LoganFraser/VoronMods/README.md

# VoronMods
My modified files for the Voron Trident and V2.4 (if cross compatible)

Logan BC CA - Logan#2225 on VoronDesign Discord

If you like my work and want to buy me a beer (or coffee),  
you can use this [Paypal](https://www.paypal.me/designbylogan) link.
