LoganFraser/VoronMods/Trident 2.4r2 Combo Inlet Skirt/README.md

These skirt plates are for the fuse-filter-switch combo c14 inlets.  

The wide one is for the larger switch in Shaffner FN283-10-06 inlets
or other equivalent product from a reputable reseller. Amazon/Aliexpress not recommended.

The narrow one is for the smaller switch in the style of adamstech inlets.  I don't have an example part number.  
 
Both Inlet

Combo Inlets
