LoganFraser/VoronMods/Displays/README.md

These are hinged 30 degree to flat cases for the BTT PiTFT43 LCD and Waveshare 4.3in DSI LCD screens.  

https://www.biqu.equipment/products/bigtreetech-pi-tft43-v2-0-screen-board

https://www.waveshare.com/4.3inch-dsi-lcd.htm

The available files are in Fusion360, step, and stl (the hinge and rear brace are common to both displays) 

BOM: 
Primarily the same as the stock display for Trident:

  1 - M3-40mm SHCS bolt
  
  2 - M3-12mm SHCS bolt
  
  2 - M3-12mm FHCS bolt
  
  2 - M3 heatset 5x4mm
  
  1 - 115mm piece of 1.75mm filament as hinge

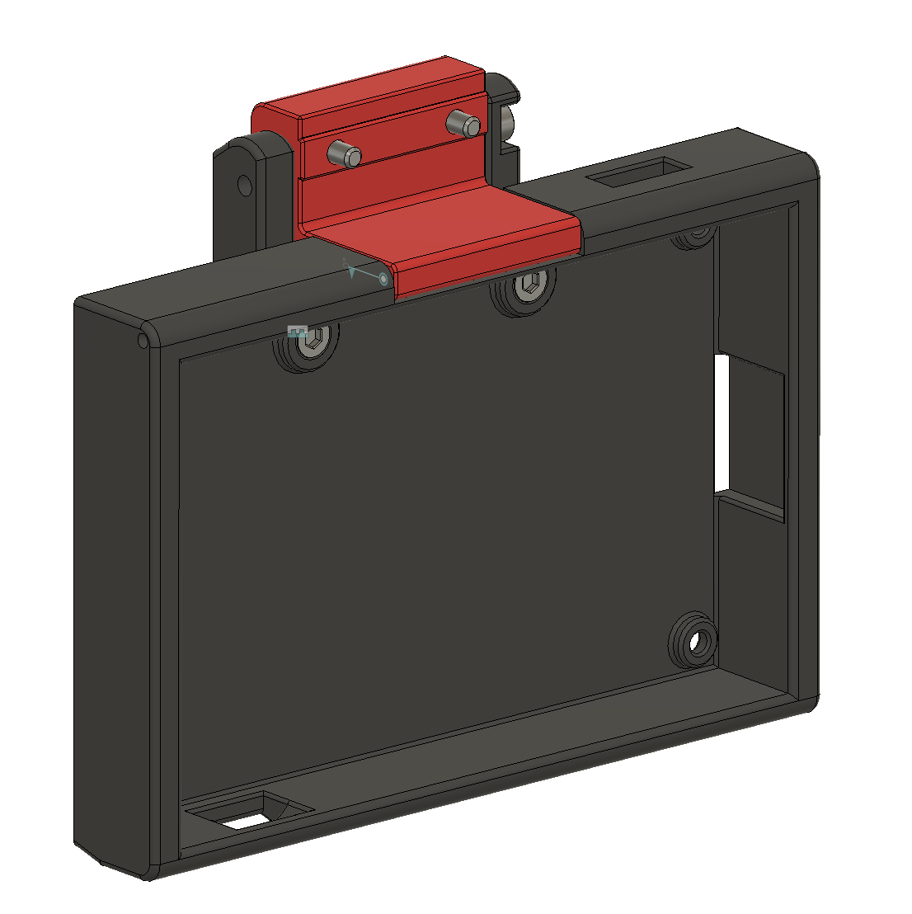
[picture p15: Displays/BTT PITFT43 LCD Mount.png]
Image of Display Mount
