LoganFraser/VoronMods/Displays/Waveshare 4.3in DSI LCD Mount.png

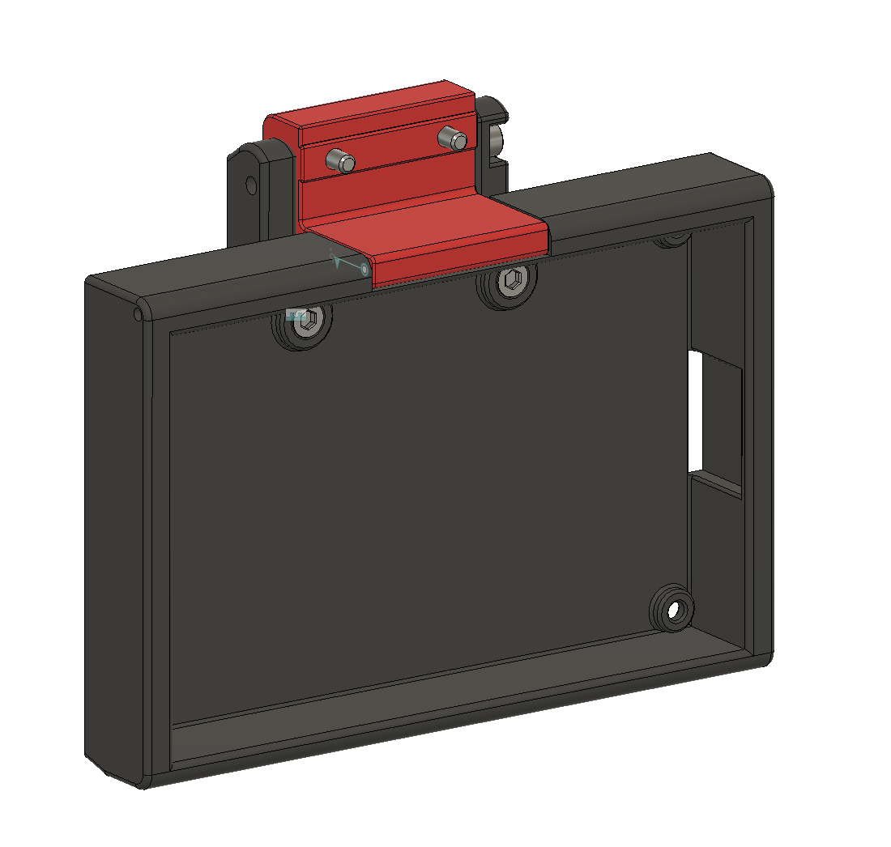
Displays/Waveshare 4.3in DSI LCD Mount.png
