LoganFraser/VoronMods/PCBs/Breakout_FFC_EXP1_PCB/Breakout_FFC_EXP1_PCB.png

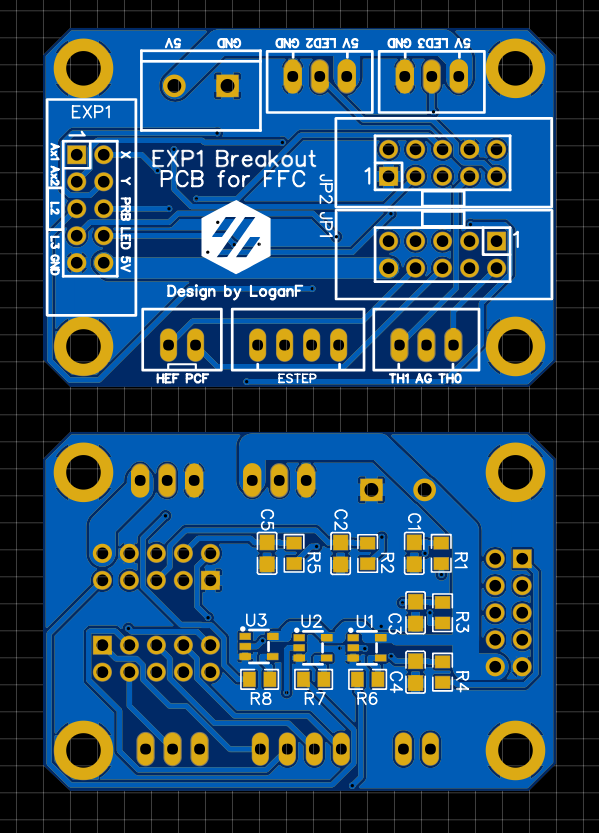
PCBs/Breakout_FFC_EXP1_PCB/Breakout_FFC_EXP1_PCB.png
