LoganFraser/VoronMods/PCBs/Breakout_Molex_EXP1_PCB/Breakout_Molex_EXP1_PCB.png

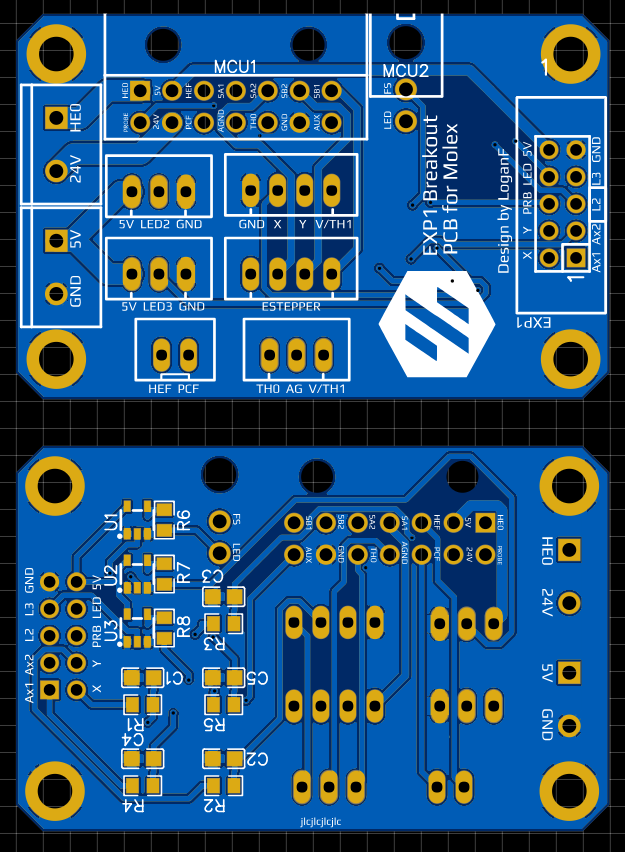
PCBs/Breakout_Molex_EXP1_PCB/Breakout_Molex_EXP1_PCB.png
