LoganFraser/VoronMods/PCBs/Stealthburner_2PC_FFC_PCB/SB_2PC_FFC_PCB.png

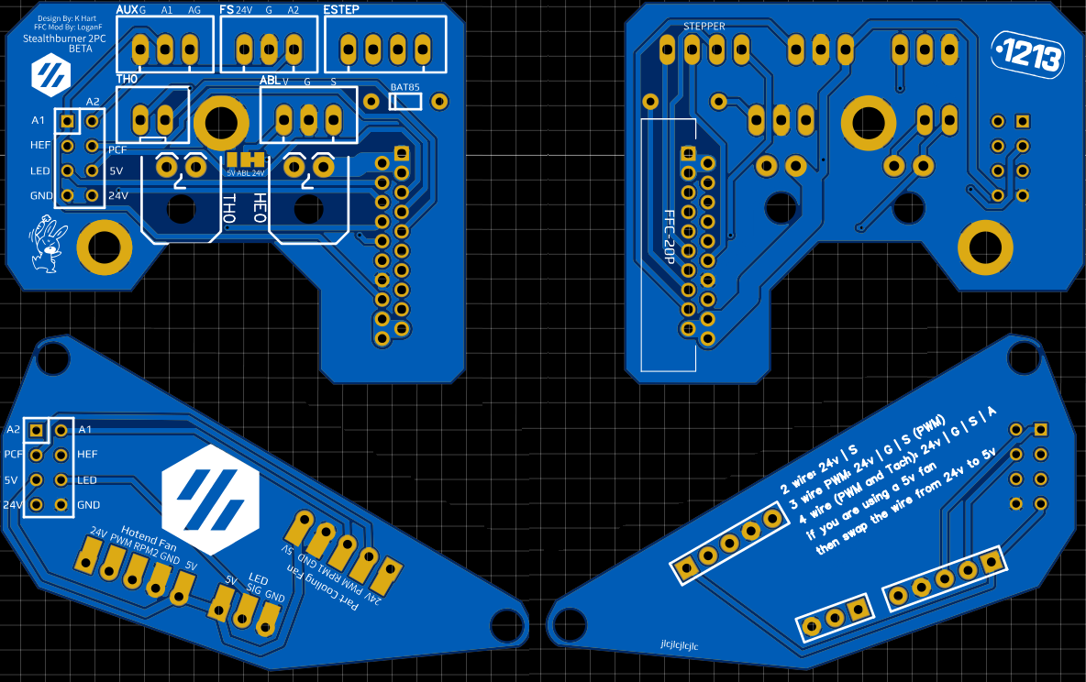
PCBs/Stealthburner_2PC_FFC_PCB/SB_2PC_FFC_PCB.png
