LoganFraser/VoronMods/PCBs/Stealthburner_2PC_Molex_PCB/SB_2PT_Molex_PCB.png

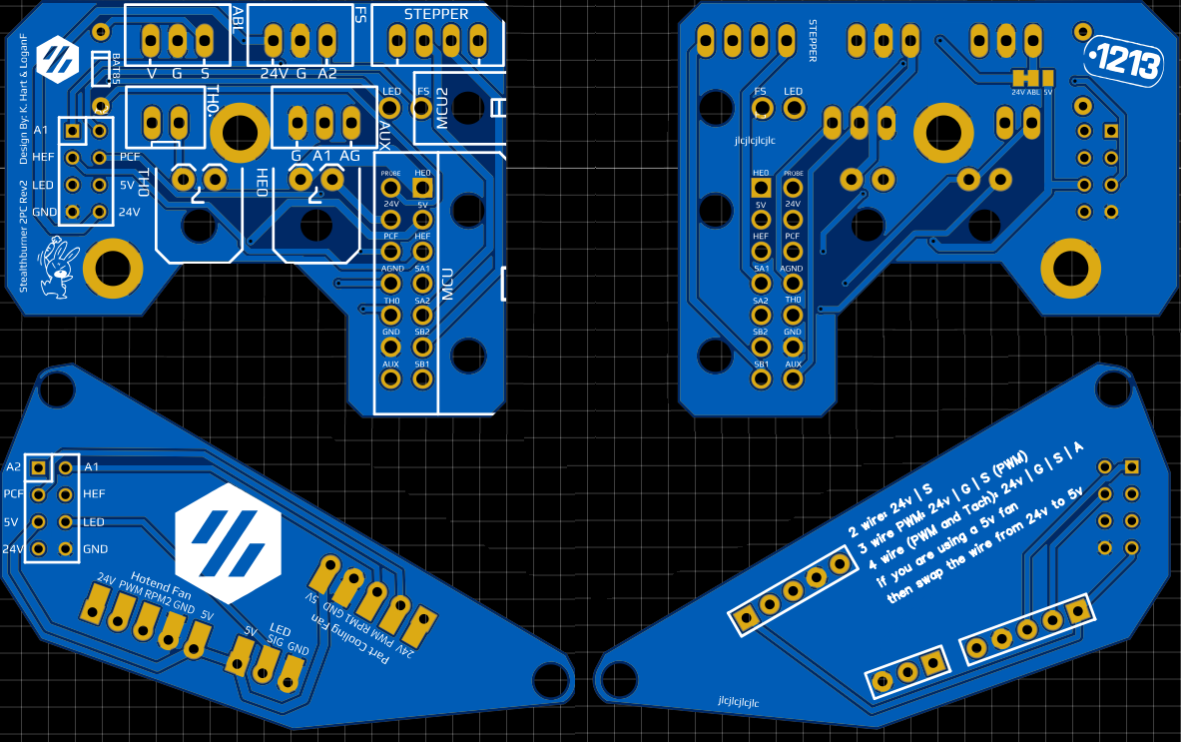
PCBs/Stealthburner_2PC_Molex_PCB/SB_2PT_Molex_PCB.png
