LoganFraser/VoronMods/PCBs/YZ_FFC_PCB/YZ_FFC_PCB.png

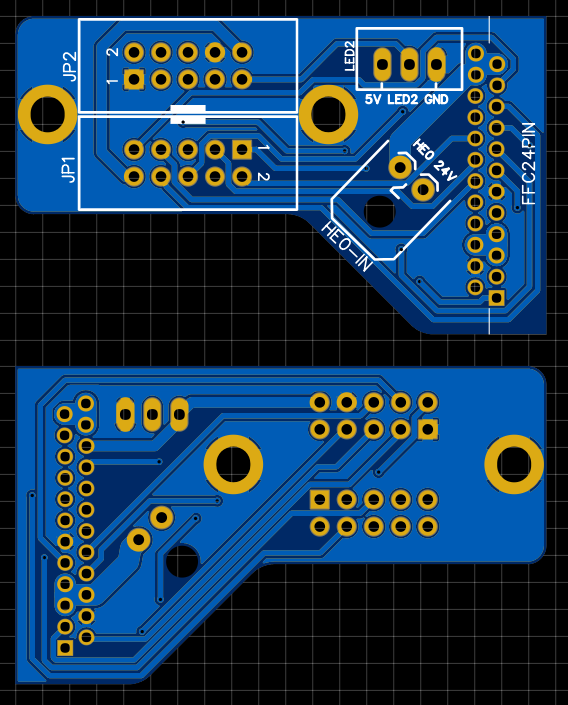
PCBs/YZ_FFC_PCB/YZ_FFC_PCB.png
