LoganFraser/VoronMods/ComboInlet/CAD/Trident_2.4_ComboInletSkirt v8.step

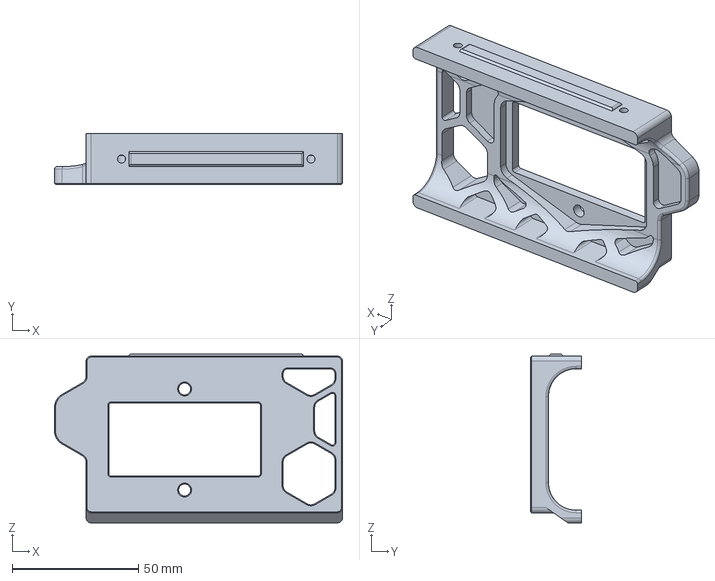
[picture p22: CAD file, 2022-06-28]
ComboInlet/CAD/Trident_2.4_ComboInletSkirt v8.step
114.0 x 20.0 x 66.8 mm
