LoganFraser/VoronMods/ComboInlet/STLs/2.4r2_ComboWideInlet.stl

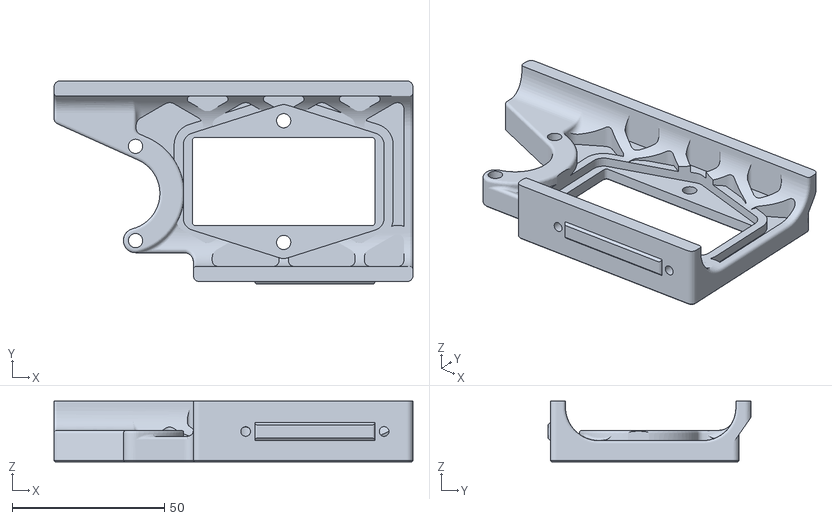
[picture p23: CAD file, 2022-06-28]
ComboInlet/STLs/2.4r2_ComboWideInlet.stl
118.0 x 66.8 x 20.0
