LoganFraser/VoronMods/DecontaminatorTrident/CAD/DecontaminatorTridentv4.step

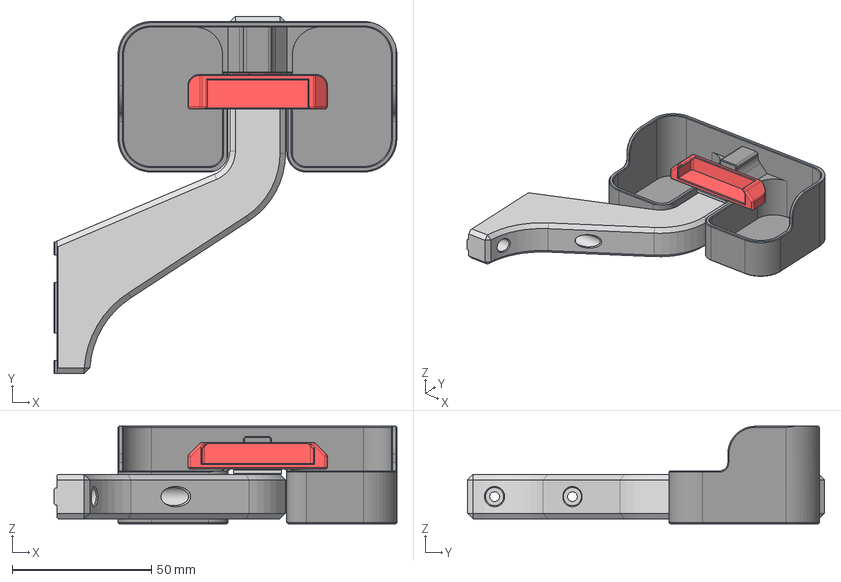
[picture p24: CAD file, 2022-05-15]
DecontaminatorTrident/CAD/DecontaminatorTridentv4.step
122.9 x 128.0 x 35.0 mm
DecontaminatorTridentBracket
BrushHolder
TridentBucket
2mmSpacer
