LoganFraser/VoronMods/DecontaminatorTrident/STLs/BrushHolder.stl

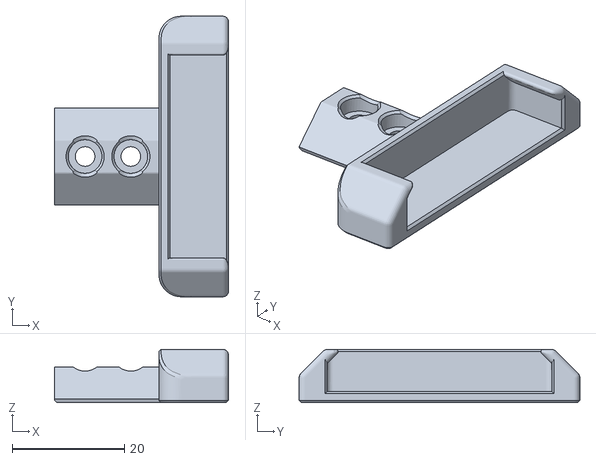
[picture p25: CAD file, 2022-05-15]
DecontaminatorTrident/STLs/BrushHolder.stl
31.0 x 50.0 x 9.50
