LoganFraser/VoronMods/Displays/Waveshare 4.3in DSI LCD Mount v2.step

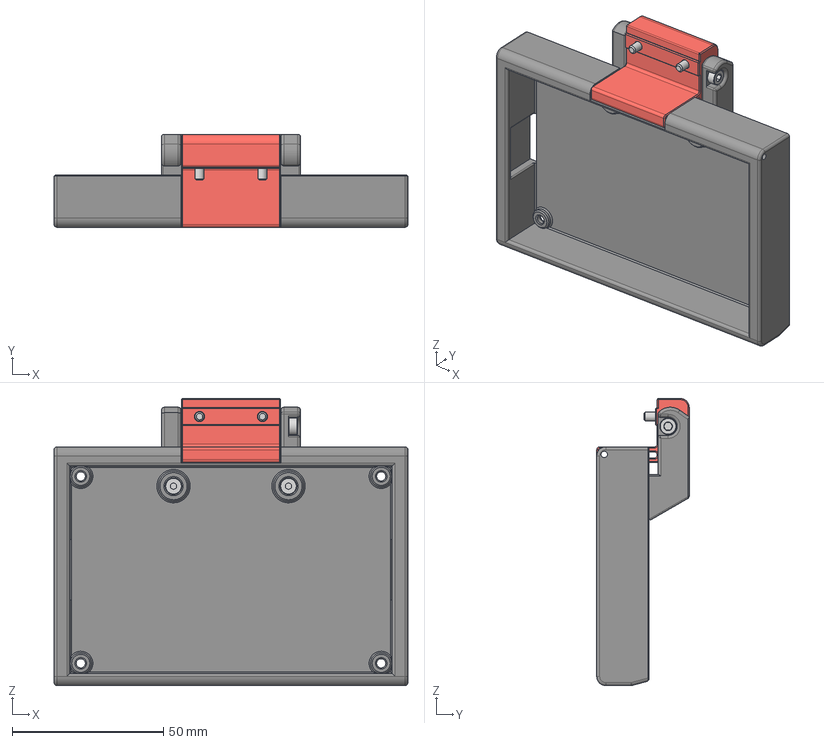
[picture p26: CAD file, 2022-02-15]
Displays/Waveshare 4.3in DSI LCD Mount v2.step
117.0 x 30.6 x 94.9 mm
LCD Case Front
M3x12 SHCS
M3x40 SHCS (5)
M3x12 SHCS (2)
M3x12 SHCS (12)
M3x12 SHCS (34)
M3x12 SHCS (33)
M3x12 SHCS (32)
M3 Threaded Insert x 2
M3x12 FHCS (1) x 2
