LoganFraser/VoronMods/HorseshoeSpoolHolder/CAD/HorseshoeSpoolHolder_v10.step

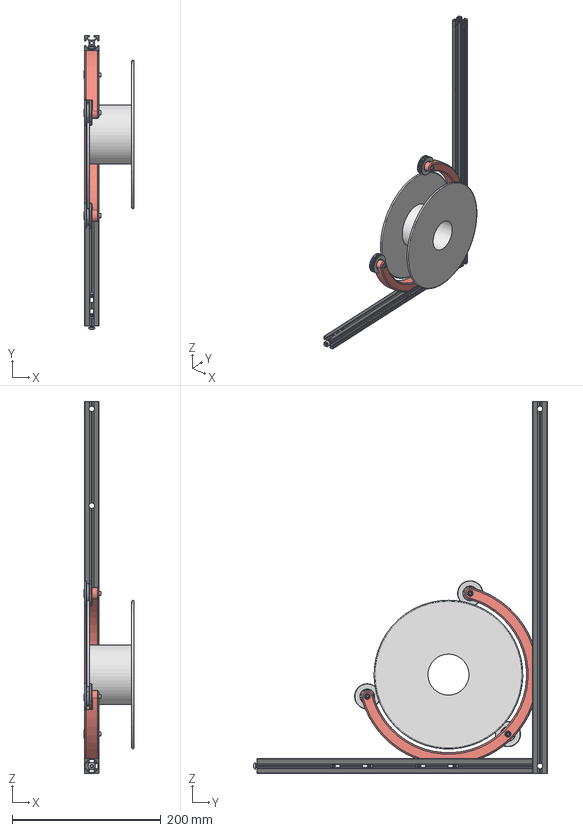
[picture p27: CAD file, 2022-05-01]
HorseshoeSpoolHolder/CAD/HorseshoeSpoolHolder_v10.step
67.2 x 394.8 x 500.0 mm
M5x16 BHCS (33)
M5x16 BHCS (32)
2020 Drop-in T-nut, M5 (28)
2020 Drop-in T-nut, M5 (31)
2020 Drop-in T-nut, M3 (38)
2020 Drop-in T-nut, M5 (32)
2020 Drop-in T-nut, M3 (39)
2020 Drop-in T-nut, M5 (52)
2020 Drop-in T-nut, M5 (51)
2020 Drop-in T-nut, M5 (50)
2020 Drop-in T-nut, M5 (49)
2020 Drop-in T-nut, M5 (48)
2020 Drop-in T-nut, M5 (47)
HFSB5-2020-500-LCP-RCP-AV360 (3)
M3x8 SHCS (3x) (1)
608BearingRing(6x)
Filament Spool
