LoganFraser/VoronMods/ParametricRemovable270Hinges/3mmPanel-1mmfoam-270swing-STLs/BackPlate 2x.stl

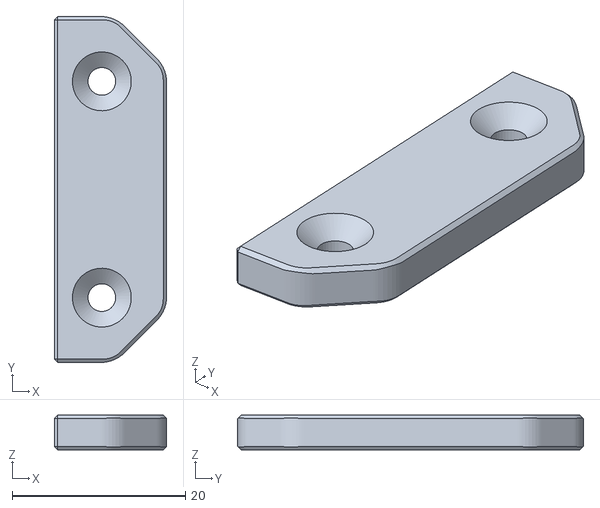
[picture p28: CAD file, 2022-04-01]
ParametricRemovable270Hinges/3mmPanel-1mmfoam-270swing-STLs/BackPlate 2x.stl
13.0 x 40.0 x 4.00
