LoganFraser/VoronMods/PCBs/FFC_Y_RISER_increased_height.stl

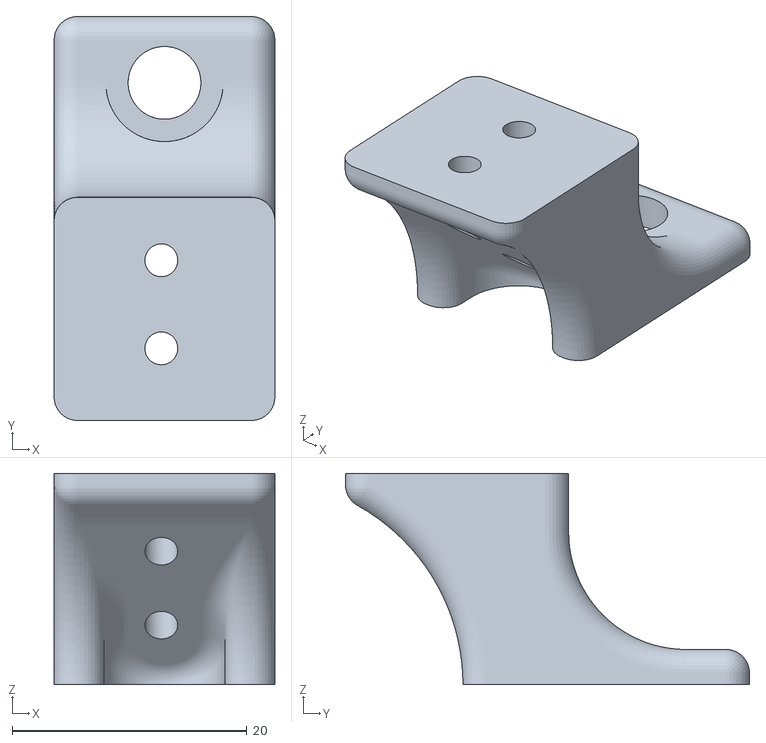
[picture p29: CAD file, 2022-01-11]
PCBs/FFC_Y_RISER_increased_height.stl
18.8 x 34.4 x 18.0
