LoganFraser/VoronMods/PiPlate/PiPlate_v16.step

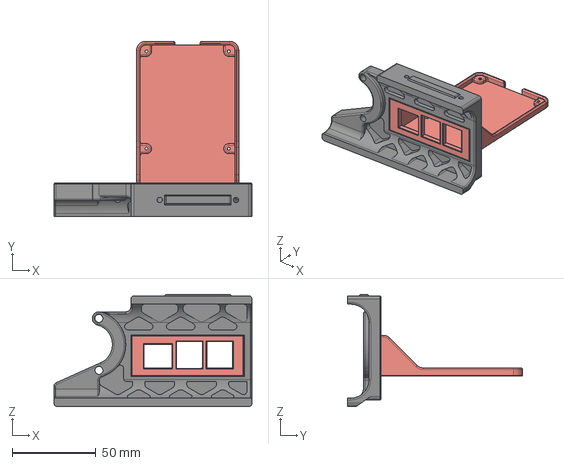
[picture p30: CAD file, 2022-04-15]
PiPlate/PiPlate_v16.step
118.0 x 104.5 x 66.8 mm
Pi3 Plate
2.4r2 Skirt for Pi Plate
