LoganFraser/VoronMods/PiPlate/STLs/2.4_250-300_Skirt_for_PiPlate.stl

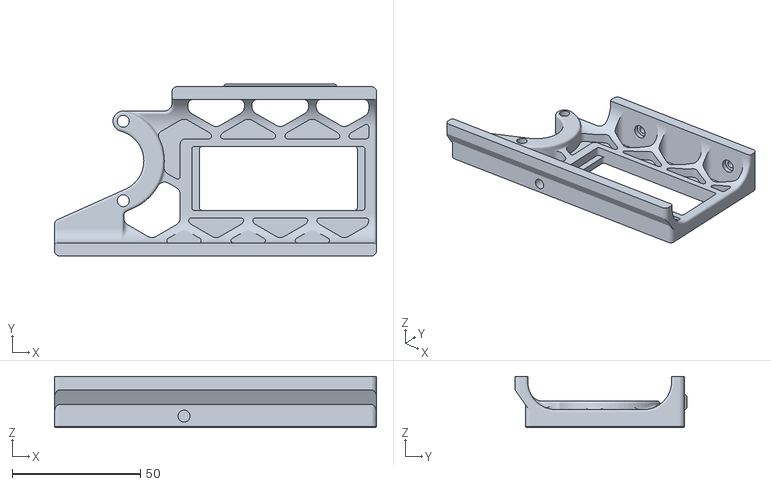
[picture p31: CAD file, 2022-04-15]
PiPlate/STLs/2.4_250-300_Skirt_for_PiPlate.stl
125.5 x 67.0 x 20.0
