LoganFraser/VoronMods/PTFEWrangler/PTFE Short Arm.stl

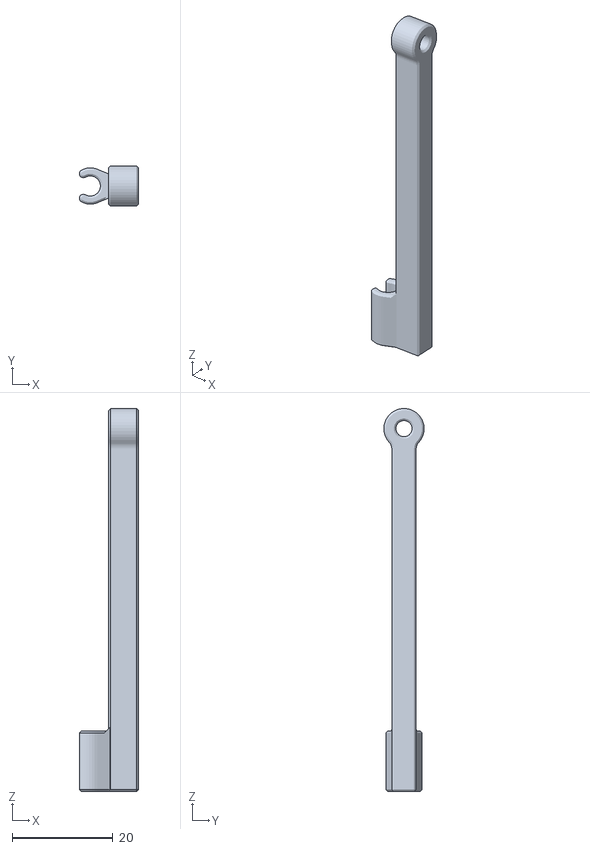
[picture p32: CAD file, 2023-12-09]
PTFEWrangler/PTFE Short Arm.stl
11.8 x 8.00 x 76.0
