LoganFraser/VoronMods/TridentInvertedElectronics/STLs/PanelLever.stl

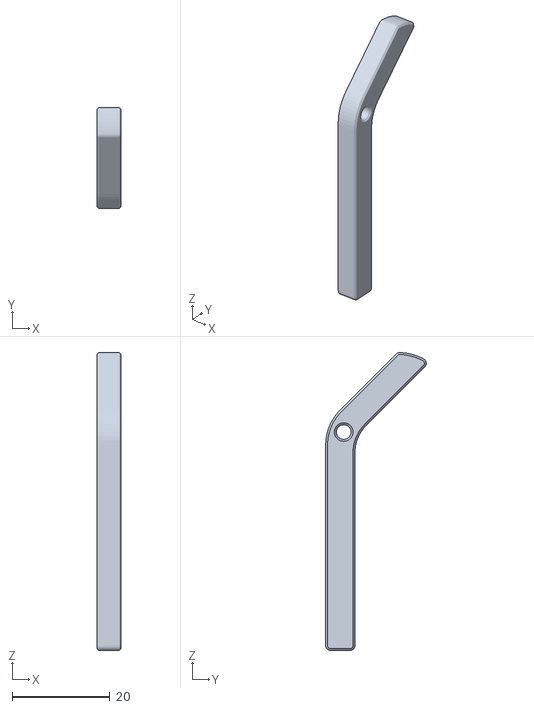
[picture p34: CAD file, 2022-05-15]
TridentInvertedElectronics/STLs/PanelLever.stl
5.00 x 20.6 x 61.0
