LoganFraser/VoronMods/TridentZStepperSpacer/STLs/Sepper_Spacer_Cover13mm.stl

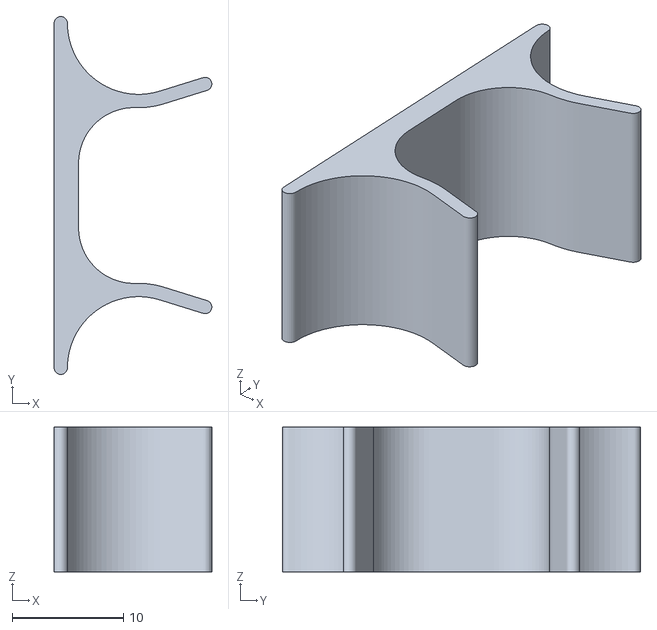
[picture p35: CAD file, 2022-03-13]
TridentZStepperSpacer/STLs/Sepper_Spacer_Cover13mm.stl
14.2 x 32.2 x 13.0
