LoganFraser/VoronMods/WagoMounts/CAD/Wago_221-41x_Extrusion_&_Thin_Din_Mount.step

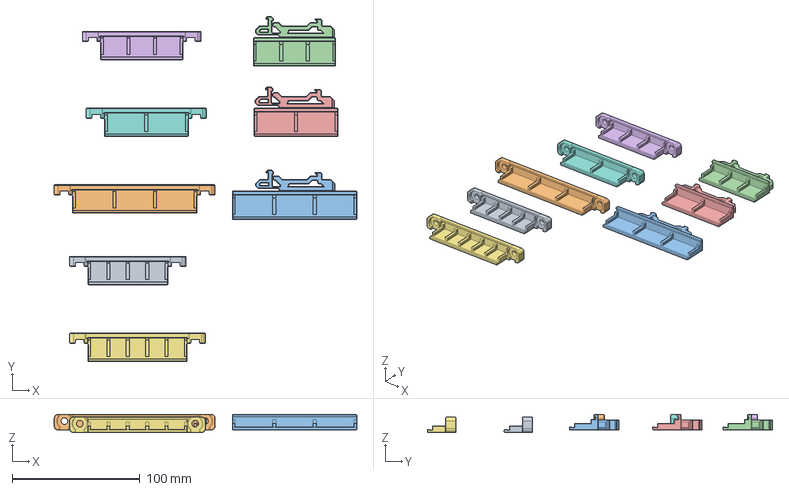
[picture p36: CAD file, 2022-02-19]
WagoMounts/CAD/Wago_221-41x_Extrusion_&_Thin_Din_Mount.step
236.7 x 269.9 x 14.2 mm
Wago 4x 221-412 Extrusion Mount
Wago 3x 221-415 Extrusion Mount x 2
M2x10 Self-tapping Screw (1)
M2x10 Self-tapping Screw (15)
Wago 3x 221-415 Thin Din Rail Mount x 2
Wago 3x 221-413 Thin Din Rail Mount
Wago 2x 221-415 Thin Din Rail Mount
Wago 3x 221-413 Extrusion Mount
Wago 5x 221-412 Extrusion Mount
Wago 2x 221-415 Extrusion Mount
