LoganFraser/VoronMods/WagoMounts/STLs/Din_Mount_Bracket.stl

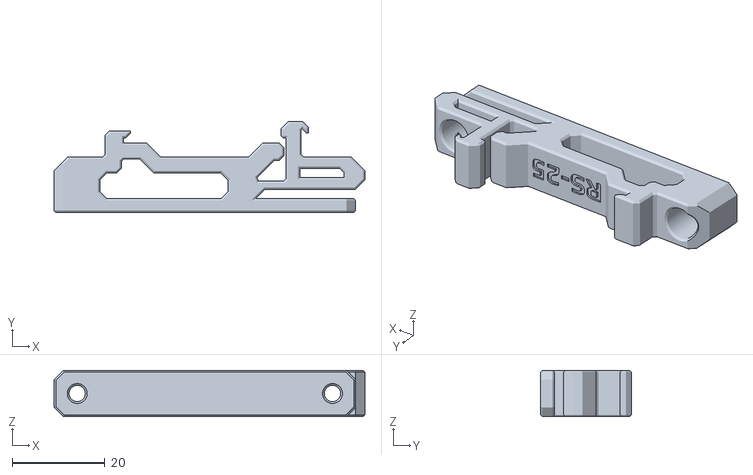
[picture p37: CAD file, 2022-04-26]
WagoMounts/STLs/Din_Mount_Bracket.stl
67.0 x 19.6 x 10.0
