LoganFraser/VoronMods/DecontaminatorTrident/STLs/4mmSpacer.stl

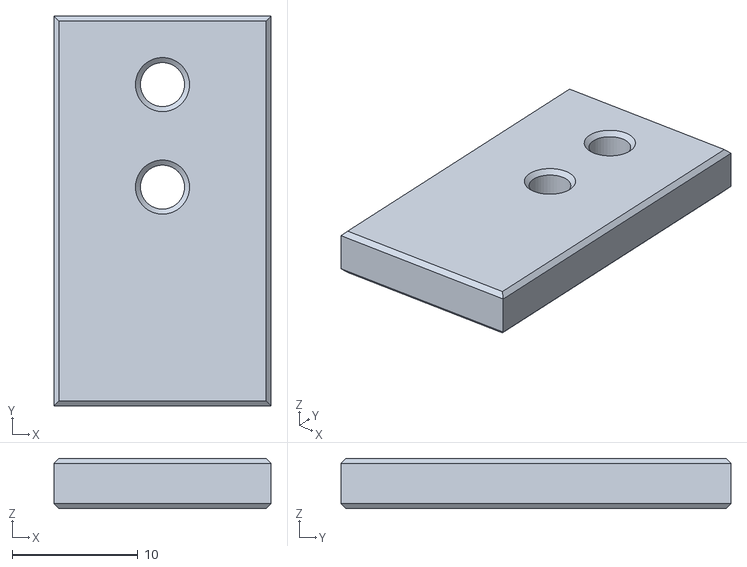
[picture p38: CAD file, 2022-05-15]
DecontaminatorTrident/STLs/4mmSpacer.stl
17.3 x 31.0 x 4.00
