LoganFraser/VoronMods/HorseshoeSpoolHolder/STLs/ExternalSpoolHolder.stl

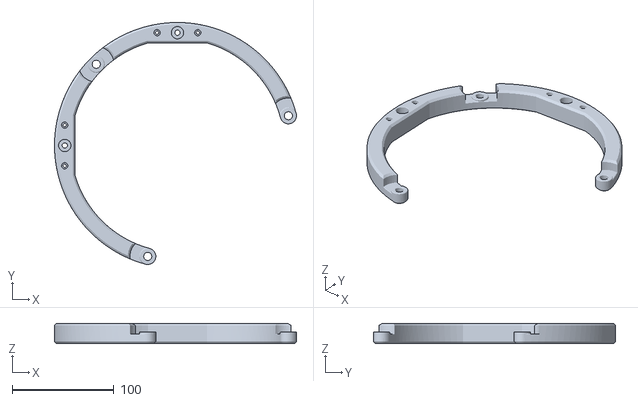
[picture p39: CAD file, 2022-05-01]
HorseshoeSpoolHolder/STLs/ExternalSpoolHolder.stl
238.1 x 238.1 x 20.0
