LoganFraser/VoronMods/ParametricRemovable270Hinges/3mmPanel-1mmfoam-270swing-STLs/HingeFrame.stl

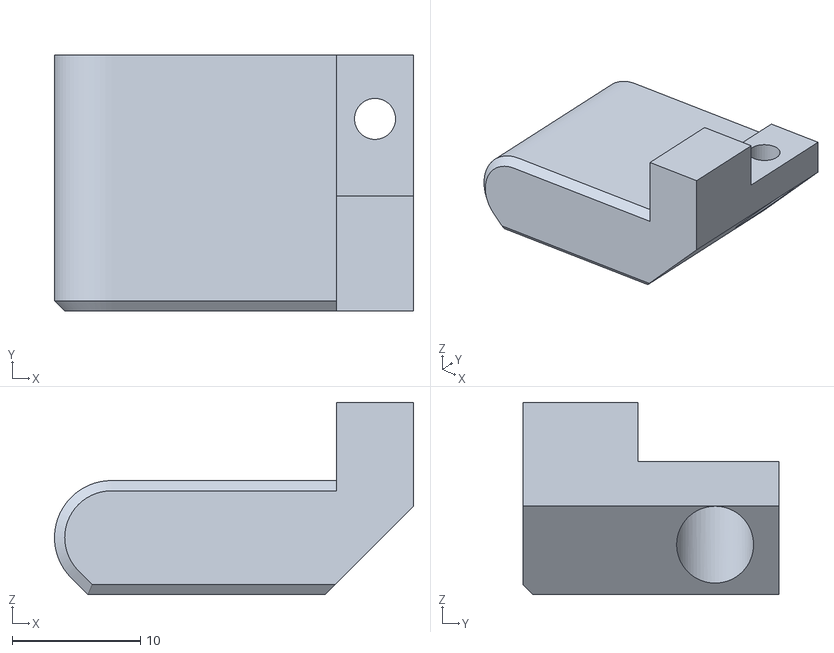
[picture p40: CAD file, 2022-04-01]
ParametricRemovable270Hinges/3mmPanel-1mmfoam-270swing-STLs/HingeFrame.stl
28.0 x 20.0 x 15.0
