LoganFraser/VoronMods/PCBs/ffc_anchor.stl

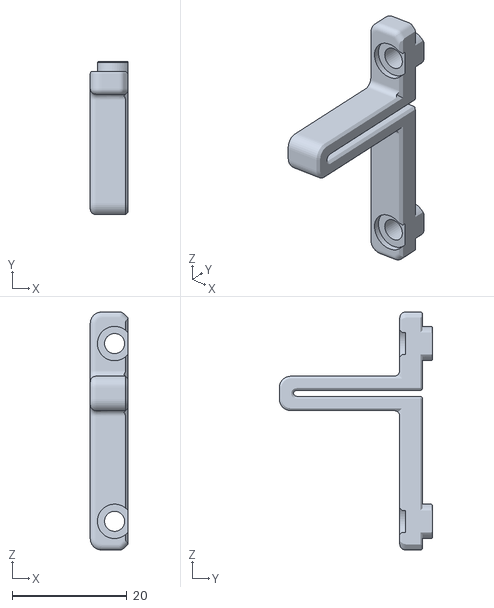
[picture p41: CAD file, 2022-01-11]
PCBs/ffc_anchor.stl
6.55 x 26.7 x 41.5
