LoganFraser/VoronMods/PiPlate/STLs/Trident_Skirt_for_PiPlate.stl

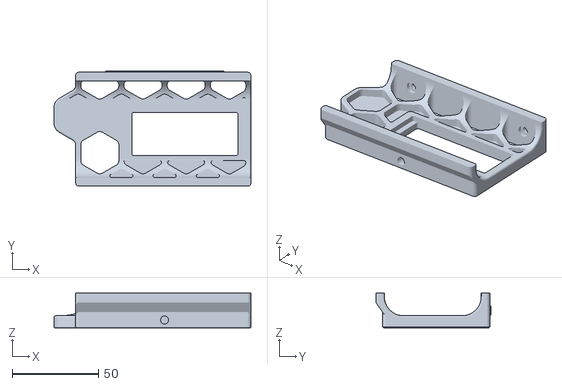
[picture p42: CAD file, 2022-04-15]
PiPlate/STLs/Trident_Skirt_for_PiPlate.stl
114.0 x 66.8 x 20.0
