LoganFraser/VoronMods/PTFEWrangler/Arm Mount.stl

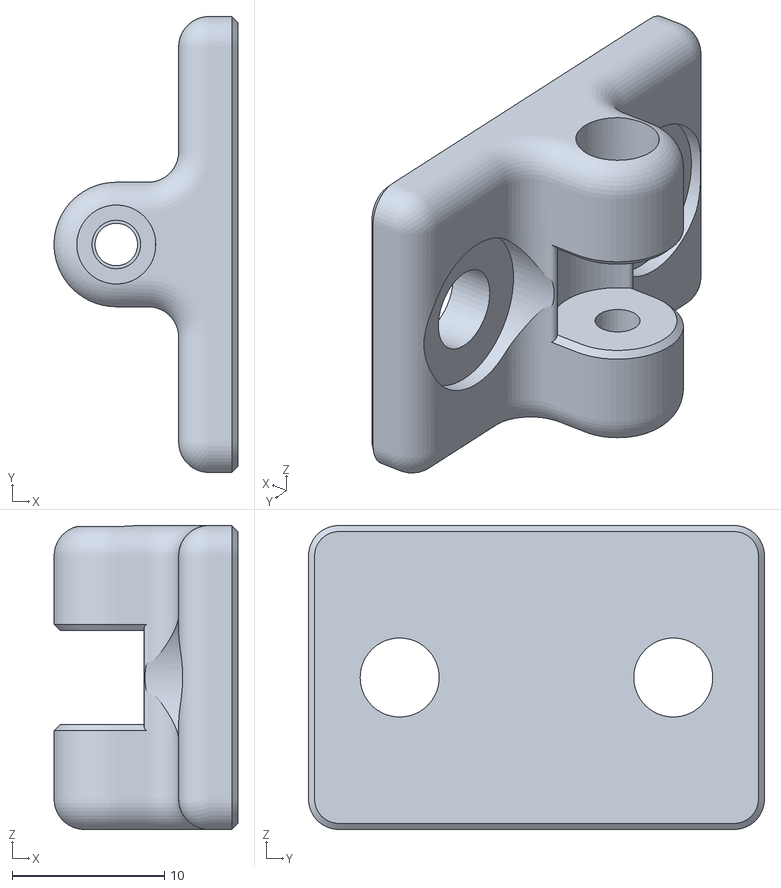
[picture p43: CAD file, 2023-12-09]
PTFEWrangler/Arm Mount.stl
12.1 x 30.0 x 20.0
