LoganFraser/VoronMods/Trident Idler Tensioner/STLs/[a]_tensioner_left.stl

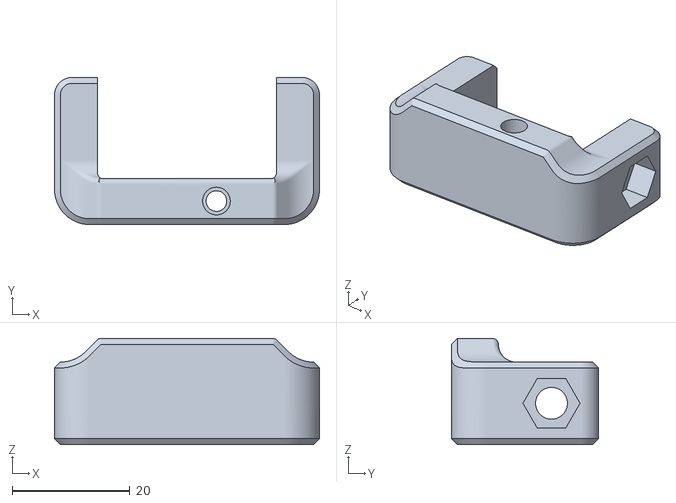
[picture p44: CAD file, 2022-02-27]
Trident Idler Tensioner/STLs/[a]_tensioner_left.stl
45.0 x 25.0 x 18.0
