LoganFraser/VoronMods/TridentInvertedElectronics/r1 STLs/Bottom_panel_clip x6.stl

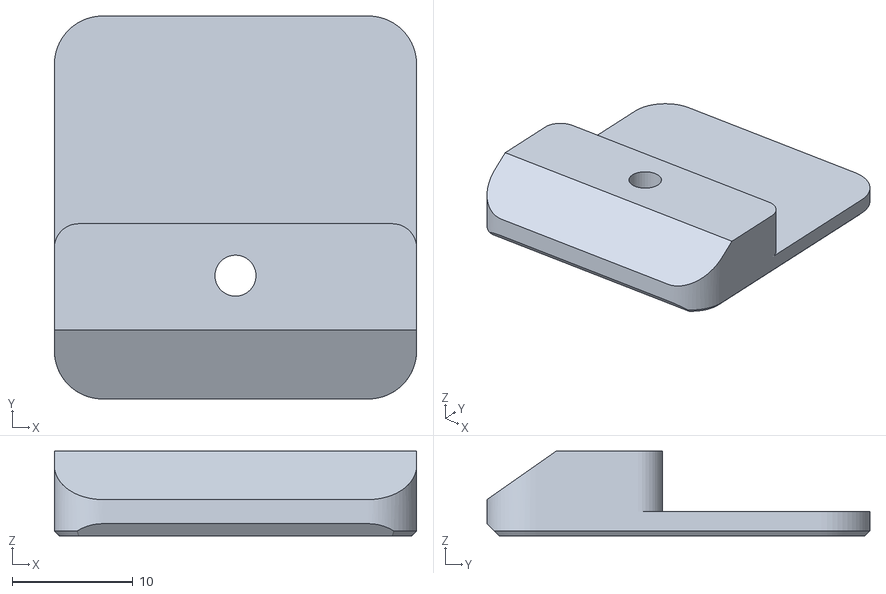
[picture p45: CAD file, 2022-02-23]
TridentInvertedElectronics/r1 STLs/Bottom_panel_clip x6.stl
30.0 x 31.7 x 7.00
