LoganFraser/VoronMods/TridentInvertedElectronics/STLs/PanelLeverFrameMount.stl

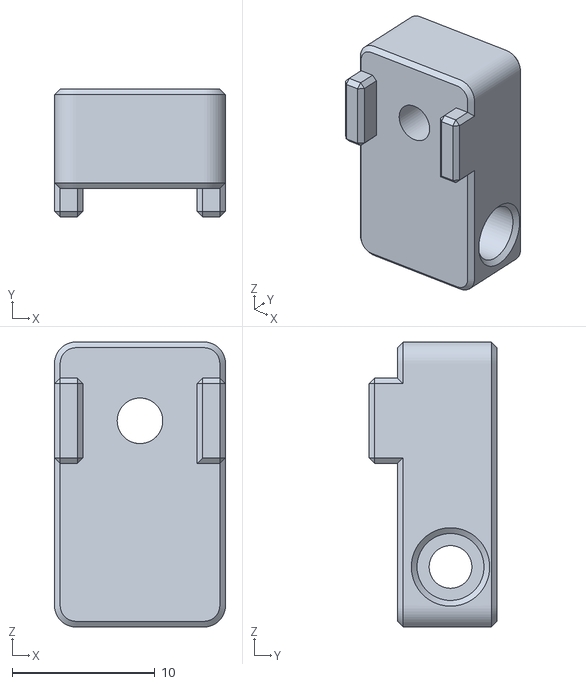
[picture p46: CAD file, 2022-05-15]
TridentInvertedElectronics/STLs/PanelLeverFrameMount.stl
12.0 x 9.00 x 20.0
