LoganFraser/VoronMods/TridentZStepperSpacer/STLs/Stepper_Spacer13mm.stl

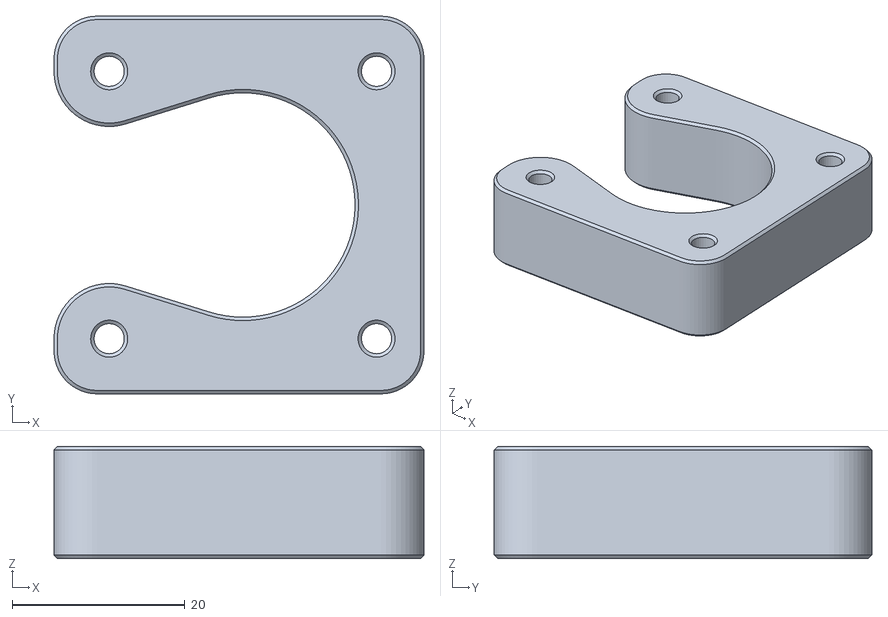
[picture p47: CAD file, 2022-03-13]
TridentZStepperSpacer/STLs/Stepper_Spacer13mm.stl
42.9 x 43.8 x 13.0
