LoganFraser/VoronMods/WagoMounts/CAD/Wago_3x_221-41x_Angled_Din_Rail_Mount.step

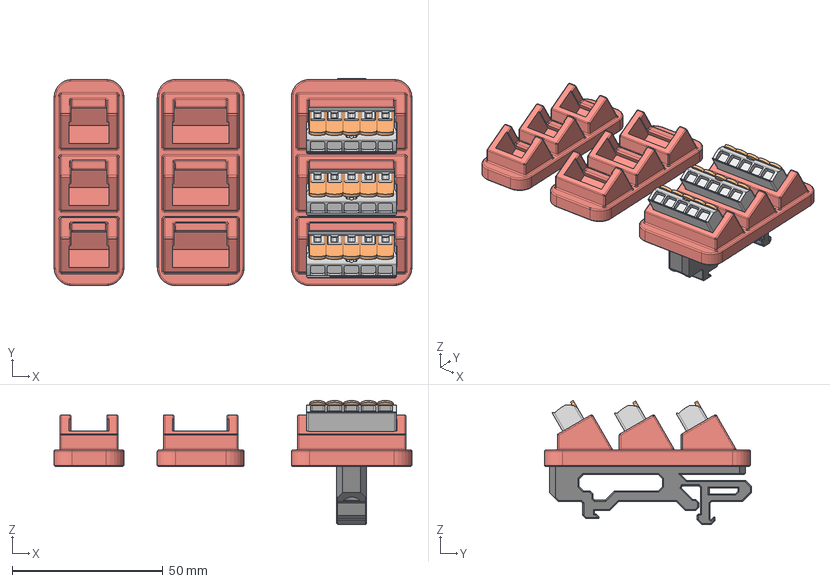
[picture p48: CAD file, 2021-12-31]
WagoMounts/CAD/Wago_3x_221-41x_Angled_Din_Rail_Mount.step
118.6 x 68.6 x 41.1 mm
Z.221-415 v1 x 2
Z.221-415 v1 (1)
Z.221-415 v1 (2)
RS-25 PSU Bracket
Wago 221-415 DIN Mount
Wago 221-413 DIN Mount
Wago 221-412 DIN Mount
