LoganFraser/VoronMods/WagoMounts/STLs/Wago_5x_221-412_Extrusion_Mount.stl

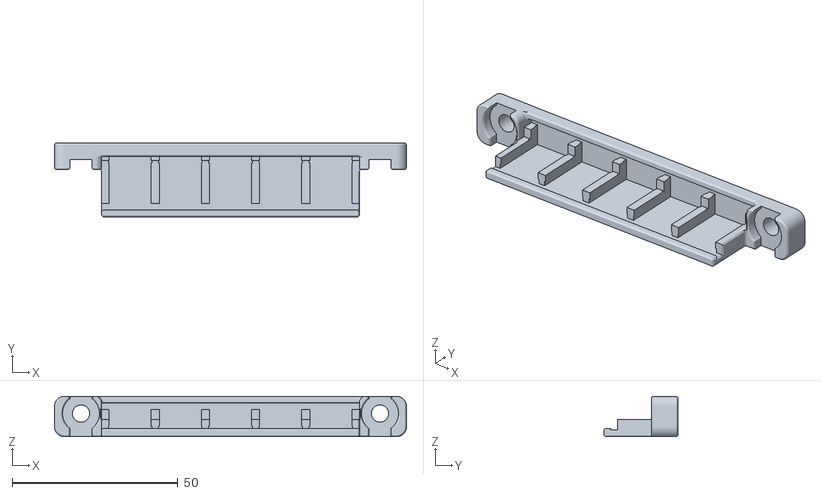
[picture p49: CAD file, 2022-02-19]
WagoMounts/STLs/Wago_5x_221-412_Extrusion_Mount.stl
106.2 x 22.2 x 12.2
