LoganFraser/VoronMods/ComboInlet/STLs/2.4r2_ComboNarrowInlet.stl

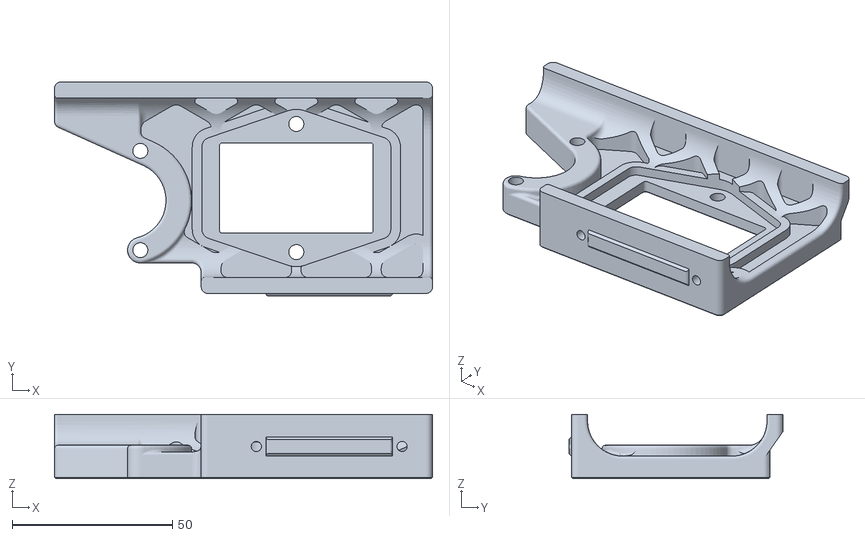
[picture p50: CAD file, 2022-06-28]
ComboInlet/STLs/2.4r2_ComboNarrowInlet.stl
118.0 x 66.8 x 20.0
