LoganFraser/VoronMods/DecontaminatorTrident/STLs/TridentBracket.stl

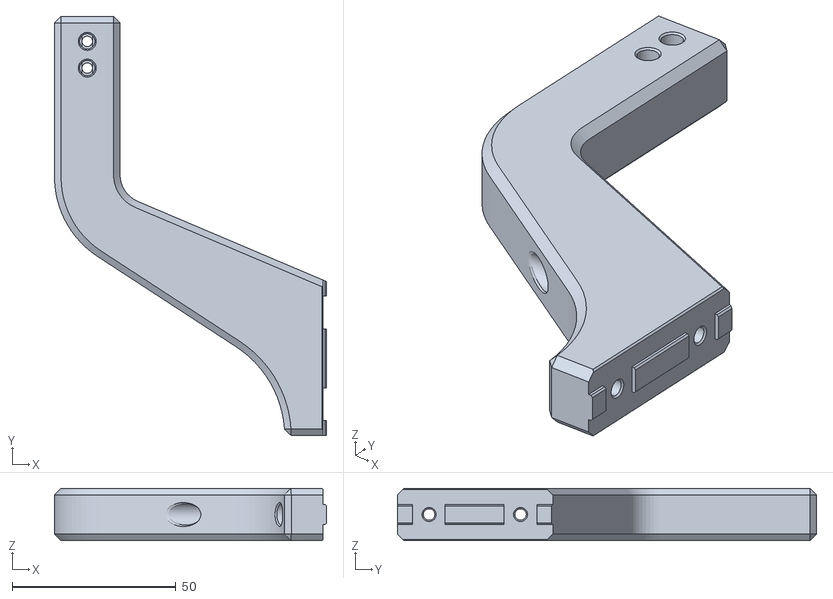
[picture p51: CAD file, 2022-05-15]
DecontaminatorTrident/STLs/TridentBracket.stl
83.0 x 128.0 x 16.0
