LoganFraser/VoronMods/Displays/LCD Case Hinge.stl

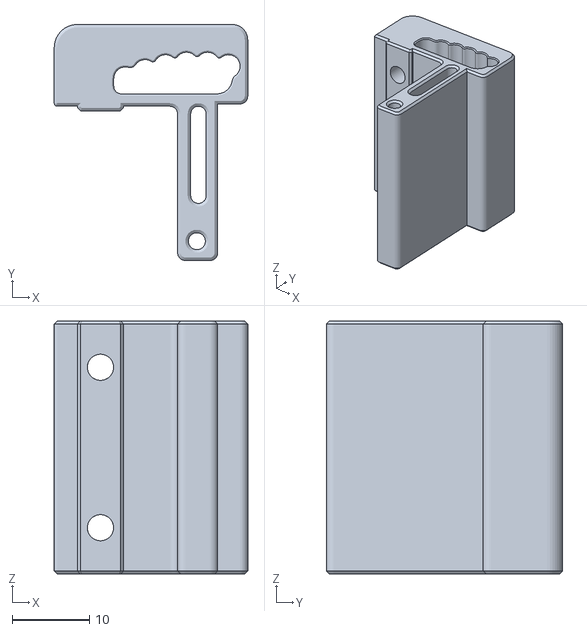
[picture p52: CAD file, 2022-02-13]
Displays/LCD Case Hinge.stl
25.1 x 30.6 x 32.8
