LoganFraser/VoronMods/ParametricRemovable270Hinges/3mmPanel-1mmfoam-270swing-STLs/Drill Guide.stl

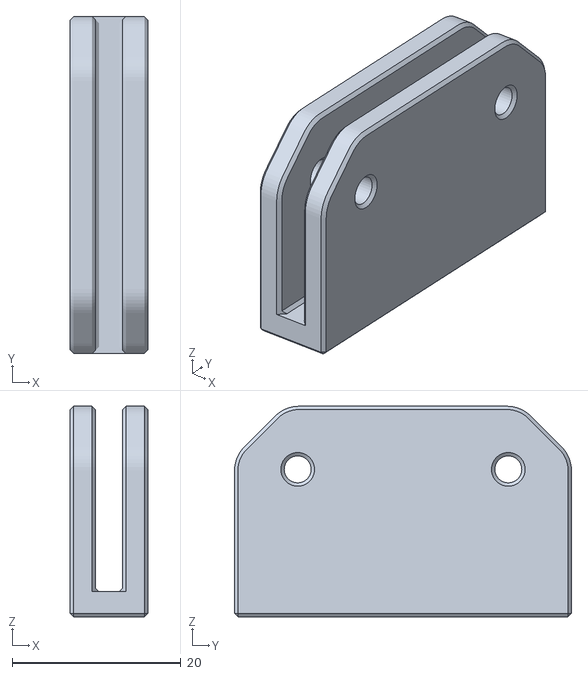
[picture p53: CAD file, 2022-04-01]
ParametricRemovable270Hinges/3mmPanel-1mmfoam-270swing-STLs/Drill Guide.stl
9.20 x 40.0 x 25.0
