LoganFraser/VoronMods/PTFEWrangler/PTFE Long Arm.stl

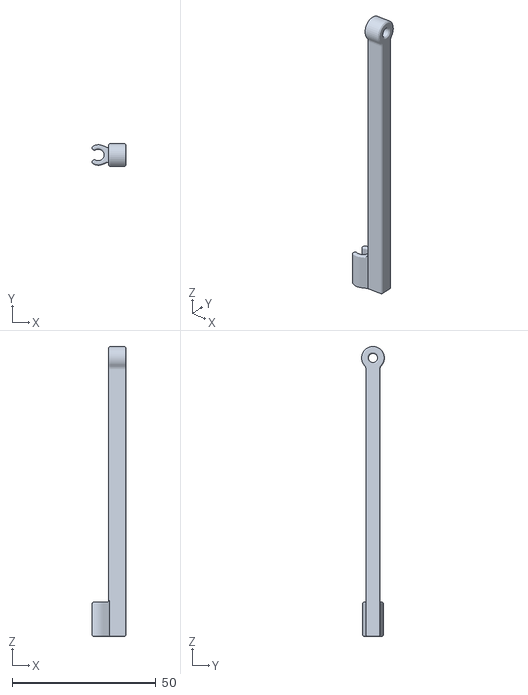
[picture p54: CAD file, 2023-12-09]
PTFEWrangler/PTFE Long Arm.stl
11.8 x 8.00 x 101.0
