LoganFraser/VoronMods/TridentInvertedElectronics/r1 STLs/Fan Cover x2.stl

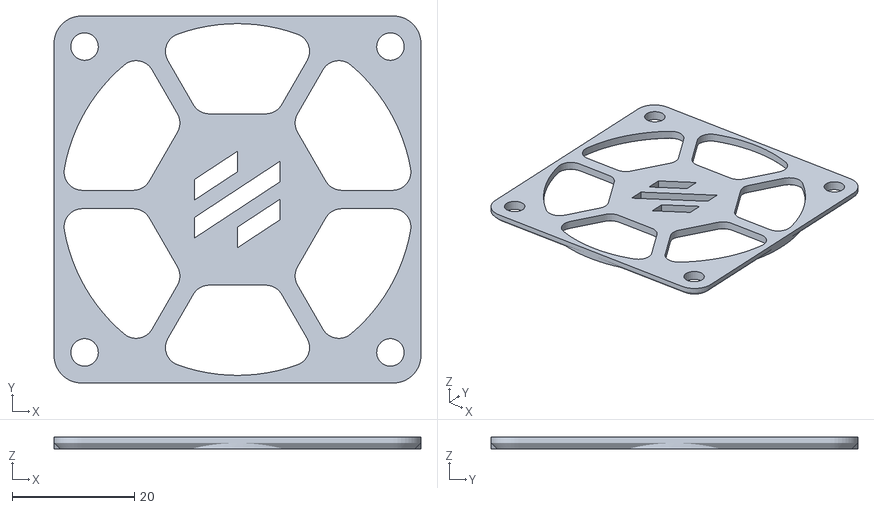
[picture p55: CAD file, 2022-02-23]
TridentInvertedElectronics/r1 STLs/Fan Cover x2.stl
60.0 x 60.0 x 2.00
