LoganFraser/VoronMods/TridentInvertedElectronics/STLs/Inverted_DIN_Mount_x2.stl

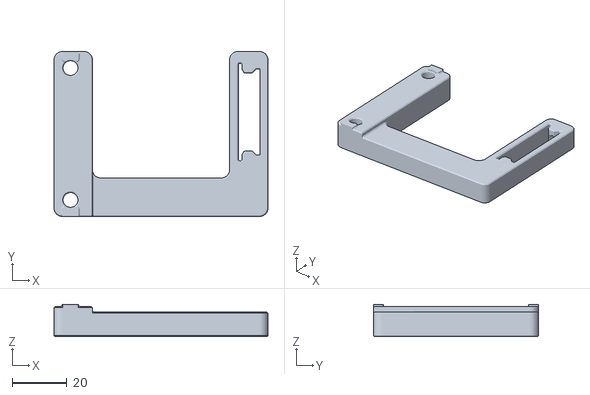
[picture p56: CAD file, 2022-04-16]
TridentInvertedElectronics/STLs/Inverted_DIN_Mount_x2.stl
77.9 x 60.0 x 11.8
