LoganFraser/VoronMods/TridentZStepperSpacer/STLs/Stepper_Spacer20mm.stl

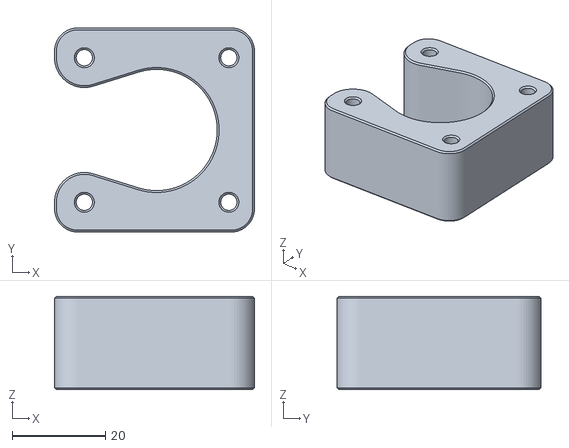
[picture p57: CAD file, 2022-03-13]
TridentZStepperSpacer/STLs/Stepper_Spacer20mm.stl
42.9 x 43.8 x 20.0
