LoganFraser/VoronMods/WagoMounts/STLs/Wago_2x_221-415_Extrusion_Mount.stl

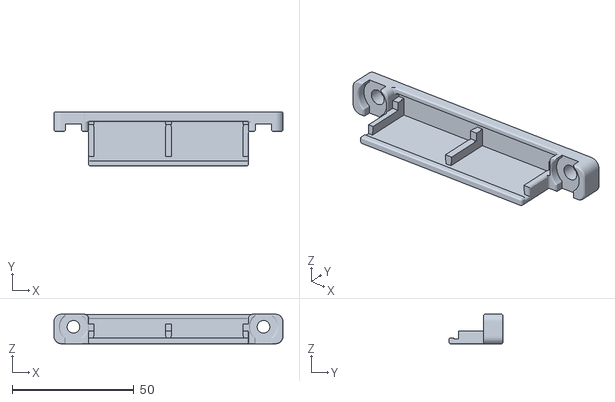
[picture p58: CAD file, 2022-02-19]
WagoMounts/STLs/Wago_2x_221-415_Extrusion_Mount.stl
94.1 x 22.2 x 12.2
