LoganFraser/VoronMods/ComboInlet/STLs/2.4_ComboWideInlet.stl

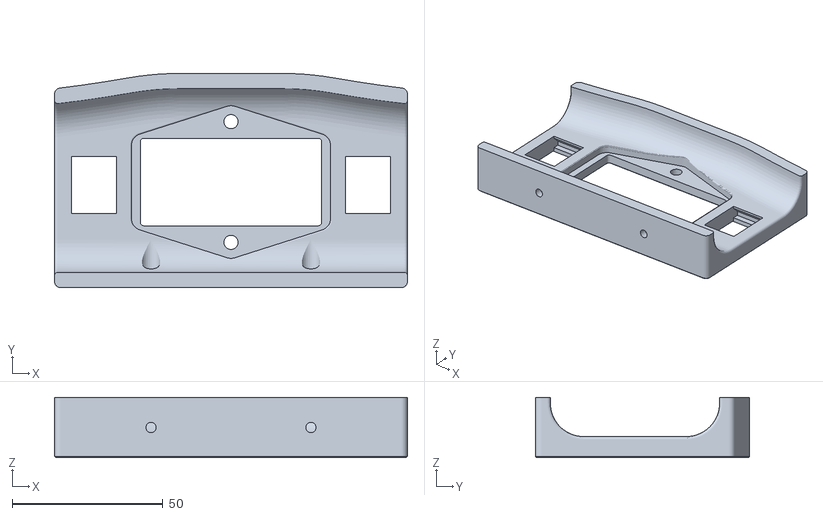
[picture p59: CAD file, 2022-06-10]
ComboInlet/STLs/2.4_ComboWideInlet.stl
117.0 x 71.0 x 20.0
