LoganFraser/VoronMods/DecontaminatorTrident/STLs/2mmSpacer.stl

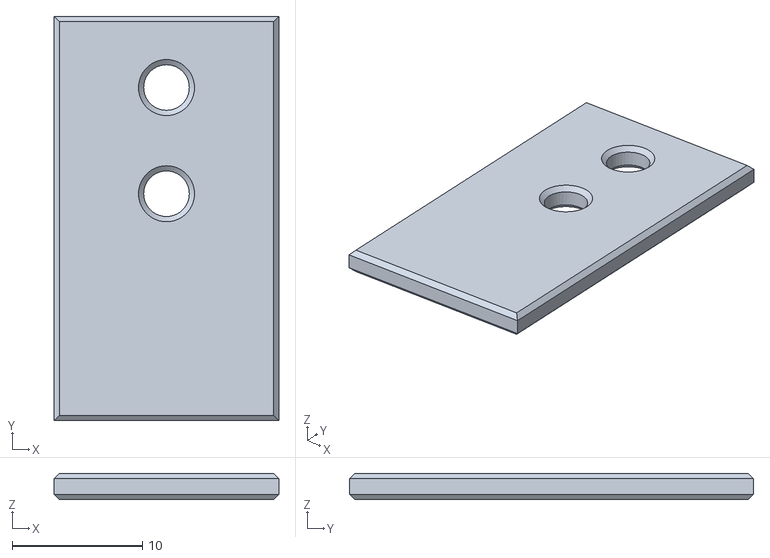
[picture p60: CAD file, 2022-05-15]
DecontaminatorTrident/STLs/2mmSpacer.stl
17.3 x 31.0 x 2.00
