LoganFraser/VoronMods/Displays/BTT PITFT43 LCD Case Front.stl

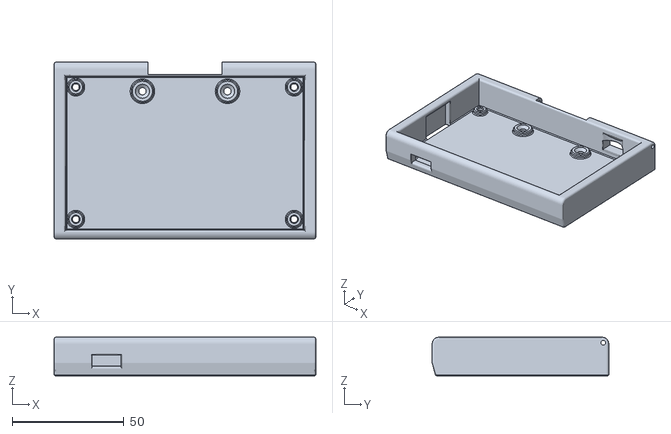
[picture p61: CAD file, 2022-02-13]
Displays/BTT PITFT43 LCD Case Front.stl
117.0 x 78.9 x 17.3
