LoganFraser/VoronMods/HorseshoeSpoolHolder/STLs/Trident_InternalSpoolHolder.stl

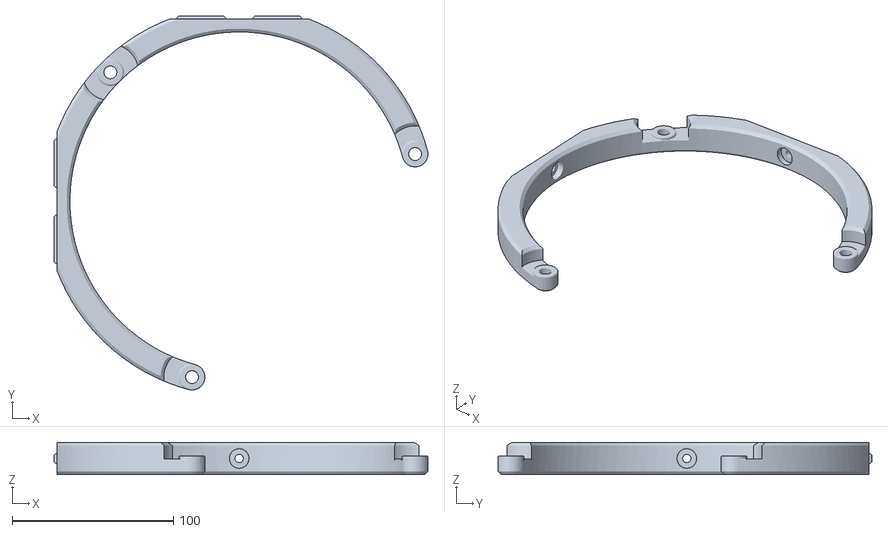
[picture p62: CAD file, 2022-04-30]
HorseshoeSpoolHolder/STLs/Trident_InternalSpoolHolder.stl
232.1 x 232.1 x 20.0
