LoganFraser/VoronMods/ParametricRemovable270Hinges/3mmPanel-1mmfoam-270swing-STLs/HingeDoor(Mirror).stl

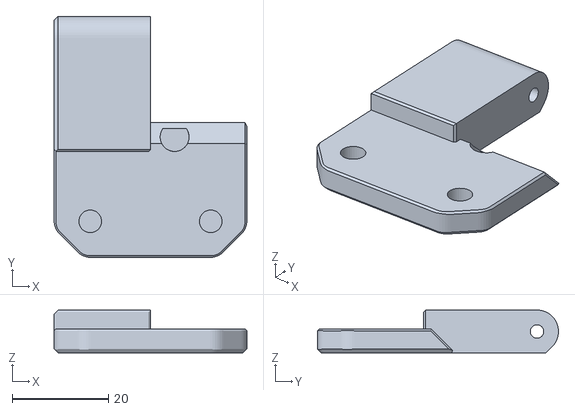
[picture p63: CAD file, 2022-04-01]
ParametricRemovable270Hinges/3mmPanel-1mmfoam-270swing-STLs/HingeDoor(Mirror).stl
40.0 x 50.0 x 8.90
