LoganFraser/VoronMods/PiPlate/STLs/2.4_350_Skirt_for_PiPlate.stl

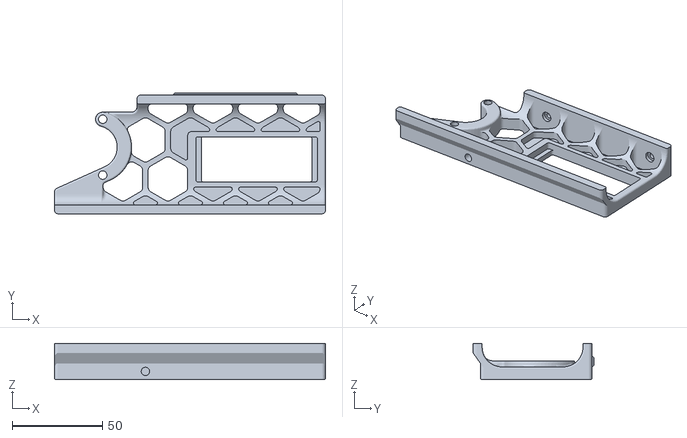
[picture p64: CAD file, 2022-04-15]
PiPlate/STLs/2.4_350_Skirt_for_PiPlate.stl
150.5 x 67.0 x 20.0
