LoganFraser/VoronMods/PTFEWrangler/90degreePTFEsupport.stl

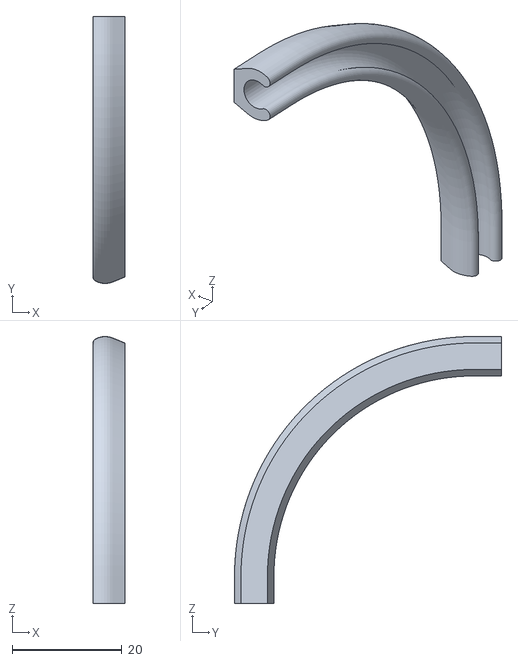
[picture p65: CAD file, 2023-12-09]
PTFEWrangler/90degreePTFEsupport.stl
5.80 x 48.6 x 48.6
