LoganFraser/VoronMods/Trident Idler Tensioner/STLs/front_idler_b_x2.stl

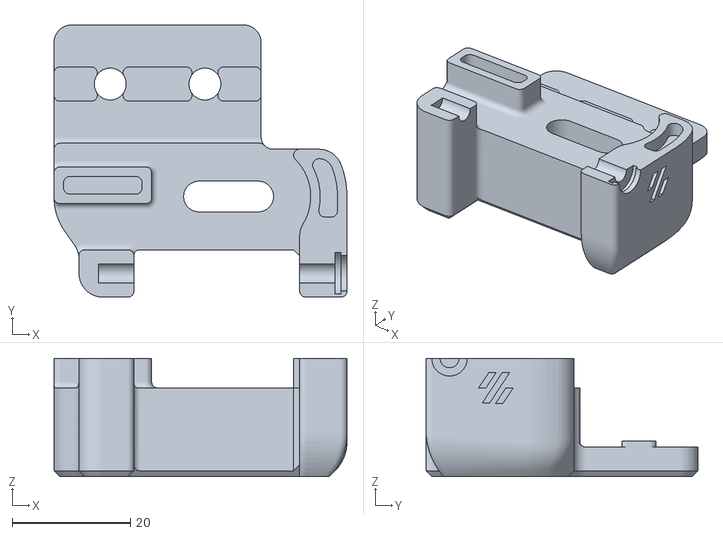
[picture p66: CAD file, 2022-02-27]
Trident Idler Tensioner/STLs/front_idler_b_x2.stl
49.5 x 46.0 x 20.0
