LoganFraser/VoronMods/TridentInvertedElectronics/r1 STLs/fan_blank x2.stl

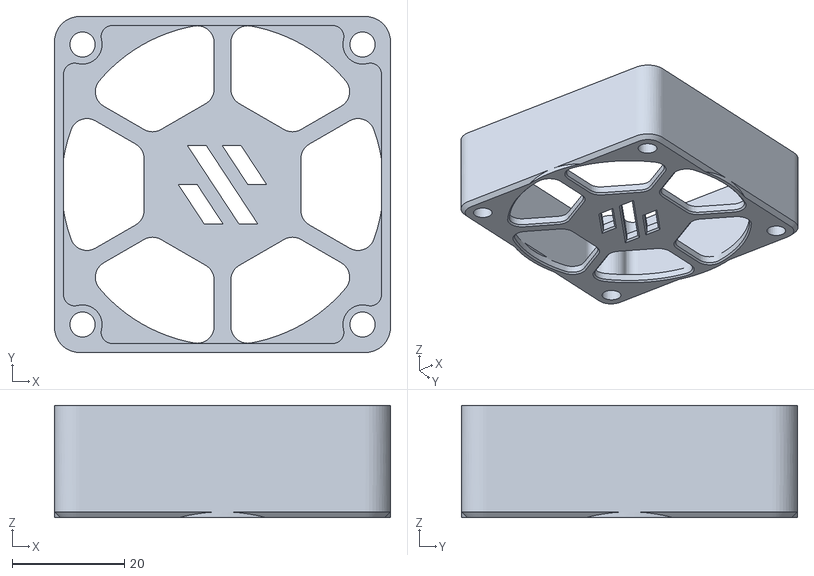
[picture p67: CAD file, 2022-02-23]
TridentInvertedElectronics/r1 STLs/fan_blank x2.stl
60.0 x 60.0 x 20.0
