LoganFraser/VoronMods/TridentZStepperSpacer/STLs/Sepper_Spacer_Cover20mm.stl

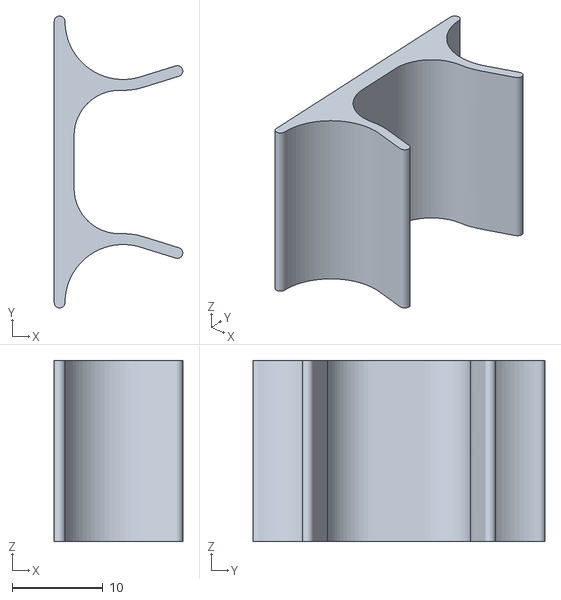
[picture p68: CAD file, 2022-03-13]
TridentZStepperSpacer/STLs/Sepper_Spacer_Cover20mm.stl
14.2 x 32.2 x 20.0
