LoganFraser/VoronMods/WagoMounts/STLs/Wago_3x_221-413_Extrusion_Mount.stl

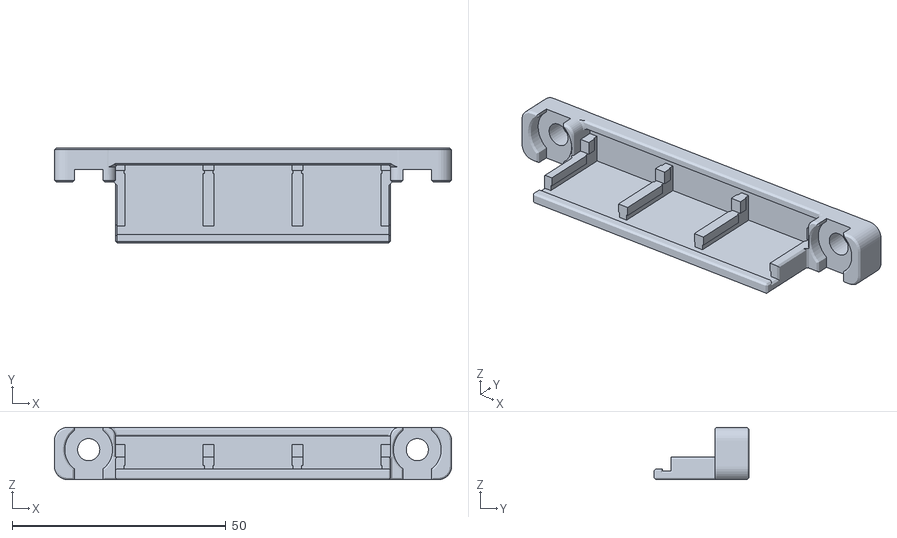
[picture p69: CAD file, 2022-02-14]
WagoMounts/STLs/Wago_3x_221-413_Extrusion_Mount.stl
92.9 x 22.3 x 12.2
