LoganFraser/VoronMods/ComboInlet/STLs/2.4_ComboNarrowInlet.stl

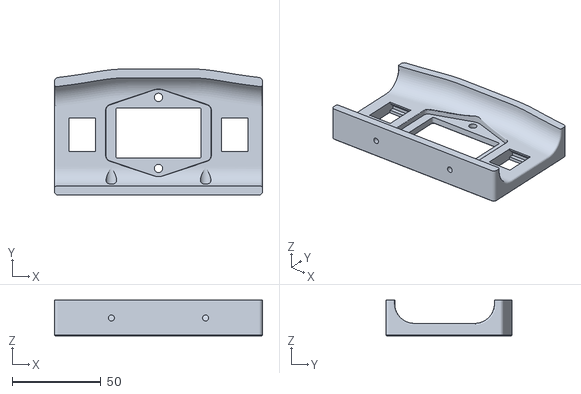
[picture p70: CAD file, 2022-04-26]
ComboInlet/STLs/2.4_ComboNarrowInlet.stl
117.0 x 71.0 x 20.0
