LoganFraser/VoronMods/DecontaminatorTrident/STLs/TridentBucket.stl

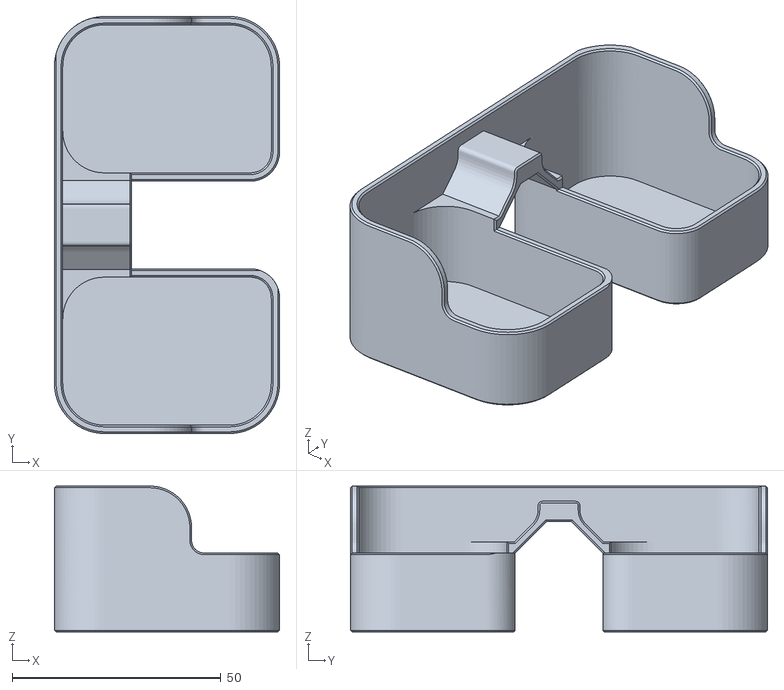
[picture p71: CAD file, 2022-05-15]
DecontaminatorTrident/STLs/TridentBucket.stl
54.0 x 100.0 x 35.0
