LoganFraser/VoronMods/Displays/LCD Case Rear Brace.stl

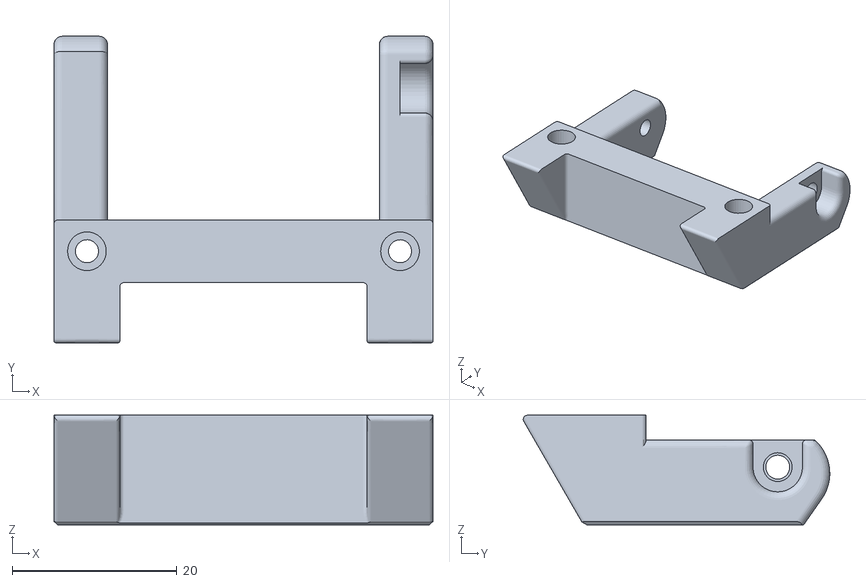
[picture p72: CAD file, 2022-02-13]
Displays/LCD Case Rear Brace.stl
46.0 x 37.2 x 13.3
