LoganFraser/VoronMods/HorseshoeSpoolHolder/STLs/608BearingRing(6x).stl

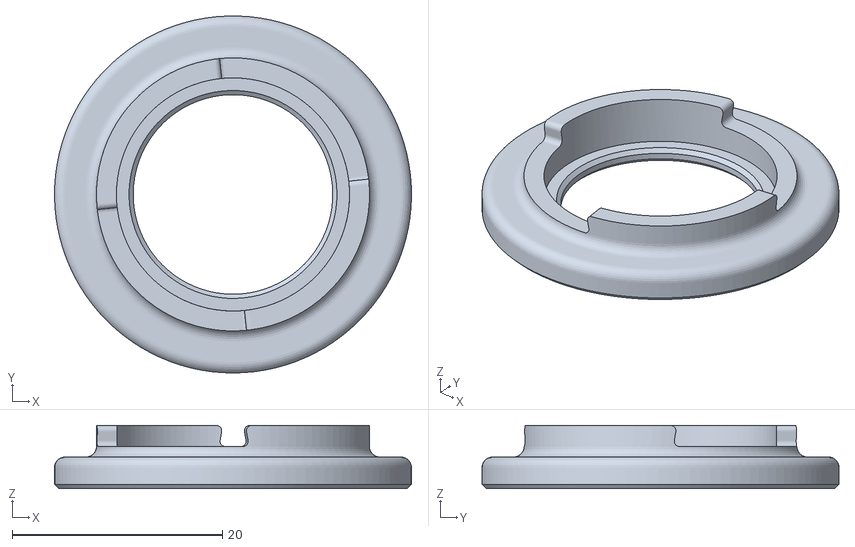
[picture p73: CAD file, 2022-04-30]
HorseshoeSpoolHolder/STLs/608BearingRing(6x).stl
34.0 x 34.0 x 6.00
