LoganFraser/VoronMods/PiPlate/STLs/2.4_250_Offset_Skirt_for_PiPlate.stl

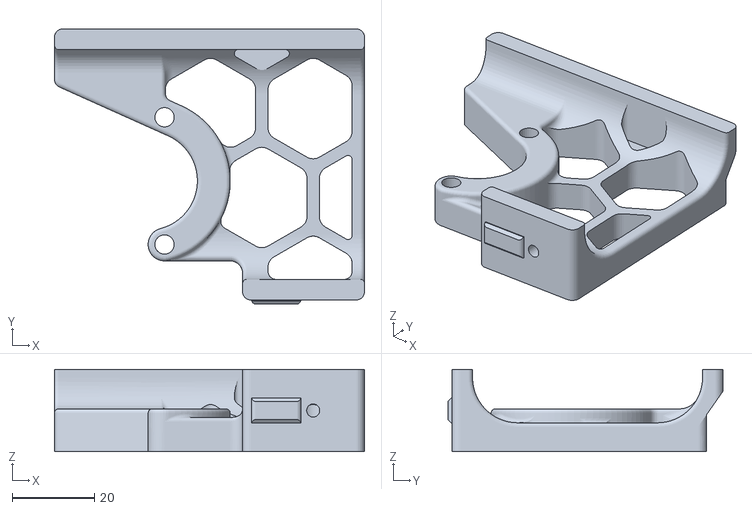
[picture p74: CAD file, 2022-04-15]
PiPlate/STLs/2.4_250_Offset_Skirt_for_PiPlate.stl
75.5 x 67.0 x 20.0
