LoganFraser/VoronMods/PTFEWrangler/PTFEsupport v6.step

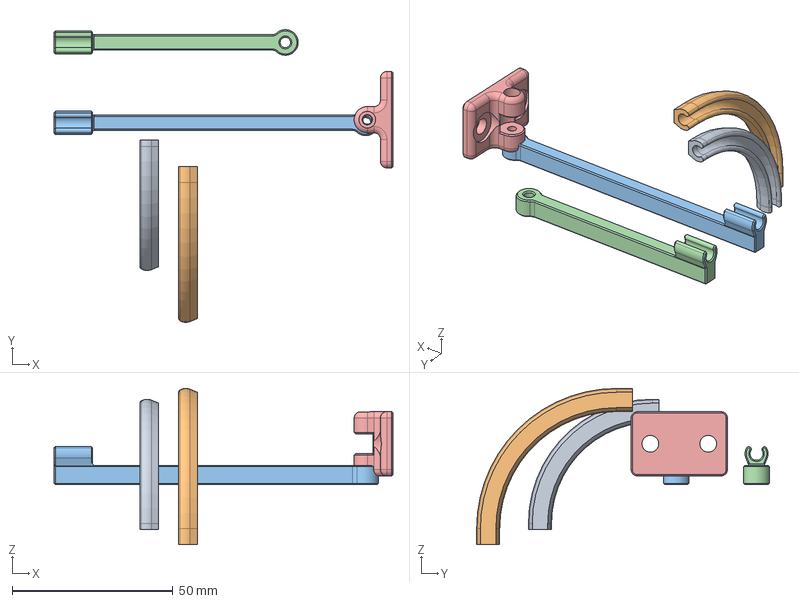
[picture p75: CAD file, 2023-12-09]
PTFEWrangler/PTFEsupport v6.step
105.5 x 91.1 x 48.6 mm
90degreePTFEsupportcompact
90degreePTFEsupport
PTFE Long Arm
PTFE Short Arm
Arm Mount
