LoganFraser/VoronMods/TridentInvertedElectronics/r1 STLs/Din Rail Support x2.stl

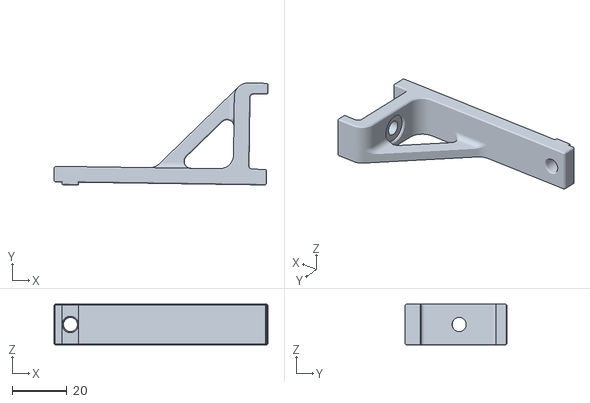
[picture p76: CAD file, 2022-02-23]
TridentInvertedElectronics/r1 STLs/Din Rail Support x2.stl
78.3 x 37.3 x 15.0
