LoganFraser/VoronMods/TridentInvertedElectronics/STLs/Z_Motor_Mount_Small_Rear.stl

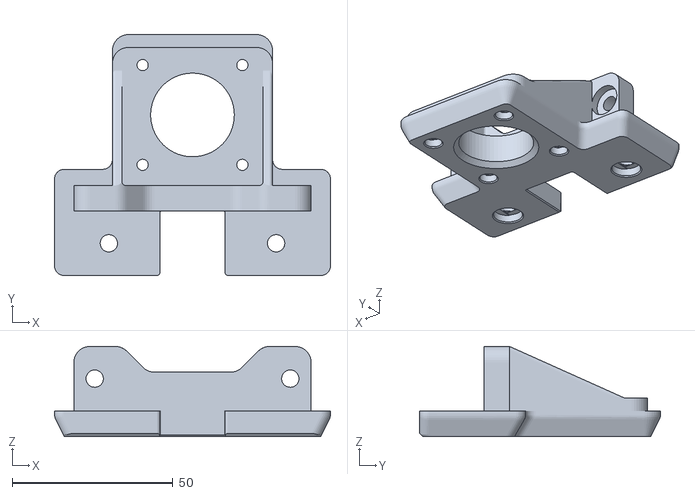
[picture p77: CAD file, 2022-04-16]
TridentInvertedElectronics/STLs/Z_Motor_Mount_Small_Rear.stl
85.8 x 74.9 x 28.0
