LoganFraser/VoronMods/WagoMounts/STLs/Wago-3x-221-413_Thin-Din_Rail_Mount.stl

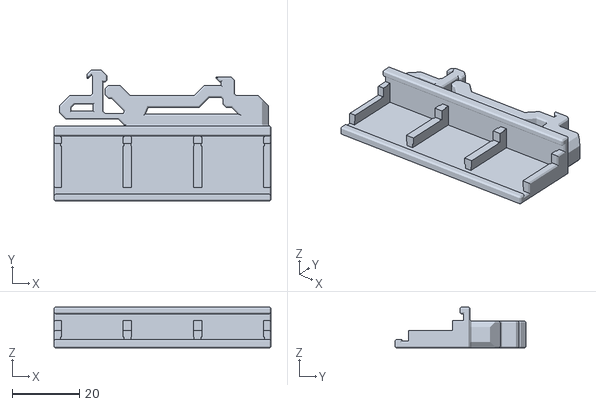
[picture p78: CAD file, 2022-02-14]
WagoMounts/STLs/Wago-3x-221-413_Thin-Din_Rail_Mount.stl
64.4 x 38.9 x 12.1
