LoganFraser/VoronMods/PiPlate/STLs/Pi3Plate.stl

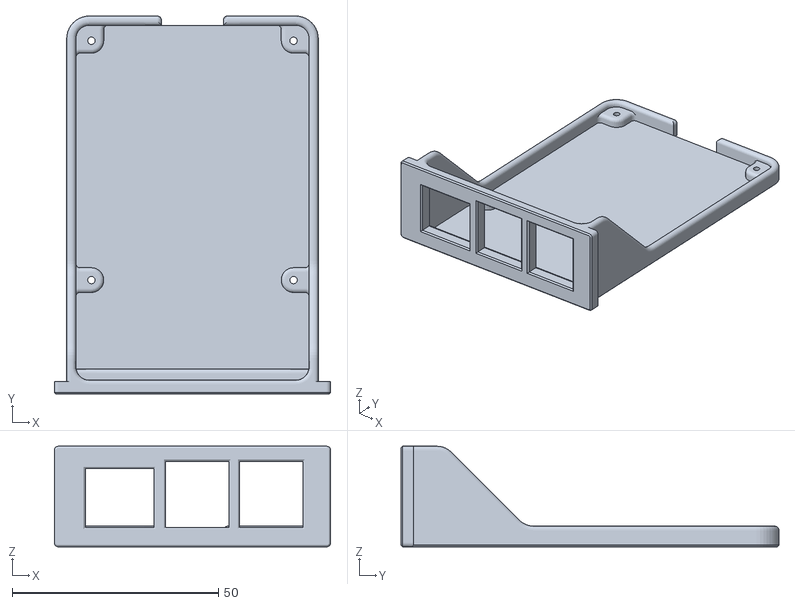
[picture p79: CAD file, 2022-02-03]
PiPlate/STLs/Pi3Plate.stl
67.0 x 91.6 x 24.4
