LoganFraser/VoronMods/PTFEWrangler/90degreePTFEsupportcompact.stl

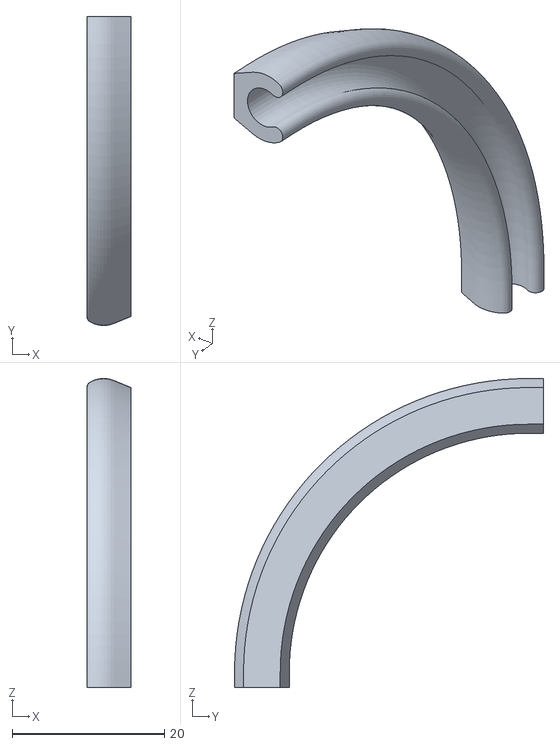
[picture p80: CAD file, 2023-12-09]
PTFEWrangler/90degreePTFEsupportcompact.stl
5.80 x 40.6 x 40.6
