LoganFraser/VoronMods/TridentInvertedElectronics/r1 STLs/Middle Fan Support x2.stl

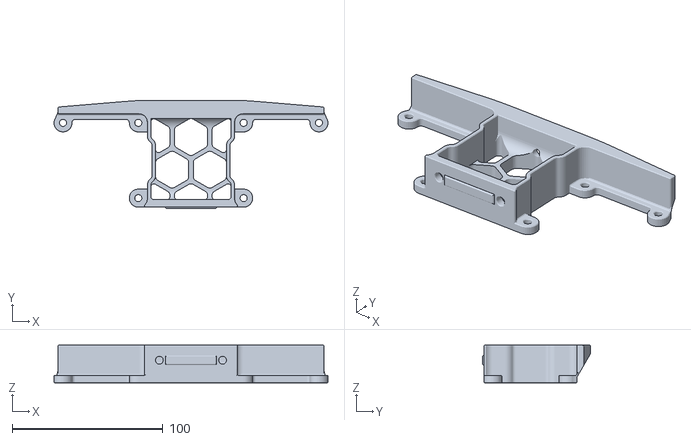
[picture p81: CAD file, 2022-02-23]
TridentInvertedElectronics/r1 STLs/Middle Fan Support x2.stl
182.0 x 72.0 x 25.0
