LoganFraser/VoronMods/TridentInvertedElectronics/STLs/Z_Motor_Mount_Small_Left.stl

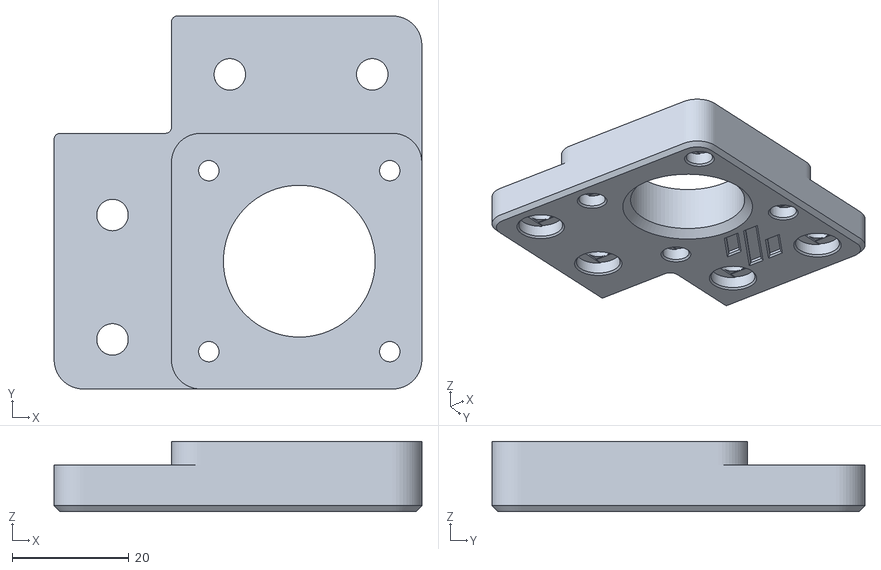
[picture p82: CAD file, 2022-02-23]
TridentInvertedElectronics/STLs/Z_Motor_Mount_Small_Left.stl
63.0 x 63.9 x 12.0
