LoganFraser/VoronMods/WagoMounts/STLs/Wago_2x_221-415_Thin_Din_Rail_Mount.stl

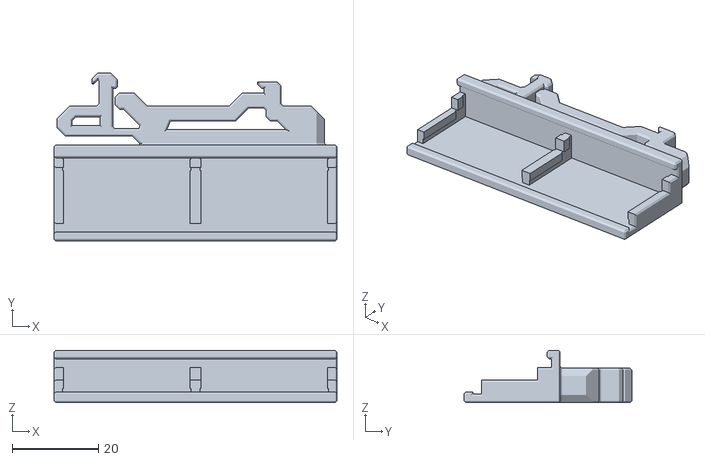
[picture p83: CAD file, 2022-02-14]
WagoMounts/STLs/Wago_2x_221-415_Thin_Din_Rail_Mount.stl
65.6 x 38.9 x 12.1
