LoganFraser/VoronMods/WagoMounts/STLs/Wago_3x_221-415_Thin_Din_Rail_Mount.stl

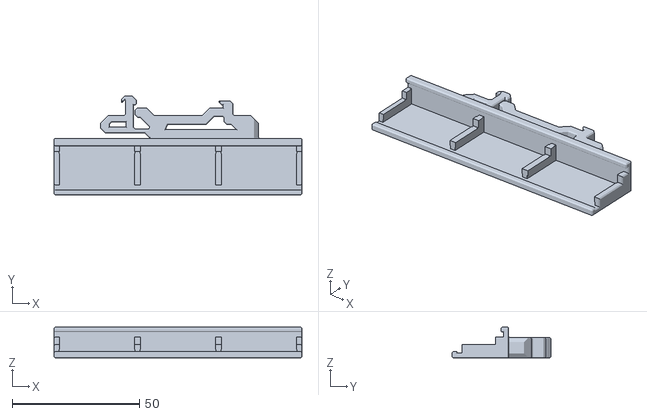
[picture p84: CAD file, 2022-02-13]
WagoMounts/STLs/Wago_3x_221-415_Thin_Din_Rail_Mount.stl
97.4 x 38.9 x 12.1
