LoganFraser/VoronMods/WagoMounts/STLs/Wago_3x_221-415_Extrusion_Mount.stl

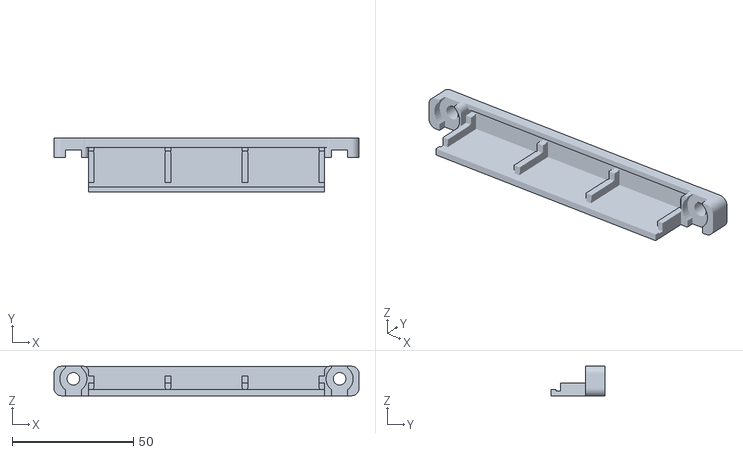
[picture p85: CAD file, 2022-01-02]
WagoMounts/STLs/Wago_3x_221-415_Extrusion_Mount.stl
125.9 x 22.3 x 12.2
