LoganFraser/VoronMods/WagoMounts/STLs/Wago_4x_221-412_Extrusion_Mount.stl

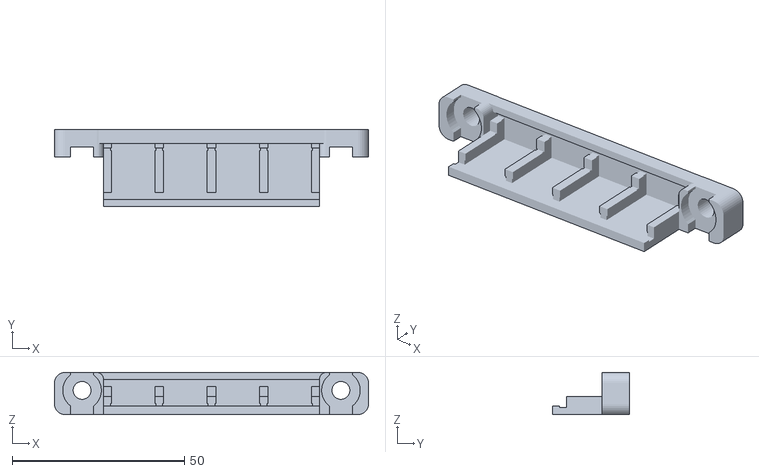
[picture p86: CAD file, 2022-01-02]
WagoMounts/STLs/Wago_4x_221-412_Extrusion_Mount.stl
91.1 x 22.3 x 12.2
