LoganFraser/VoronMods/WagoMounts/STLs/Wago_3x_221-415_Skirt_Inlet_Mount.stl

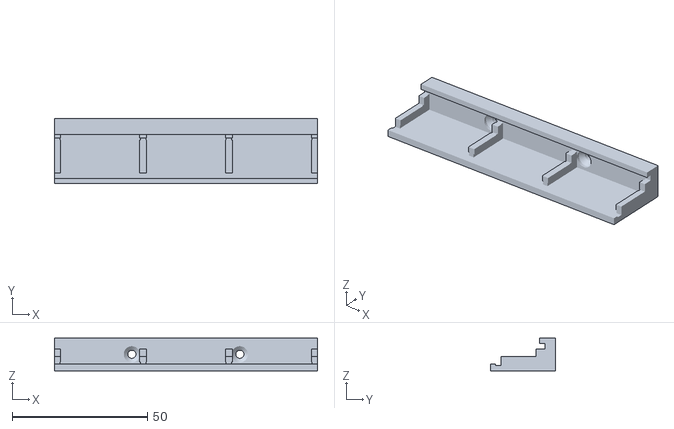
[picture p87: CAD file, 2022-01-02]
WagoMounts/STLs/Wago_3x_221-415_Skirt_Inlet_Mount.stl
97.4 x 24.2 x 12.2
