LoganFraser/VoronMods/WagoMounts/STLs/Wago_3x_221-412_DIN_Mount.stl

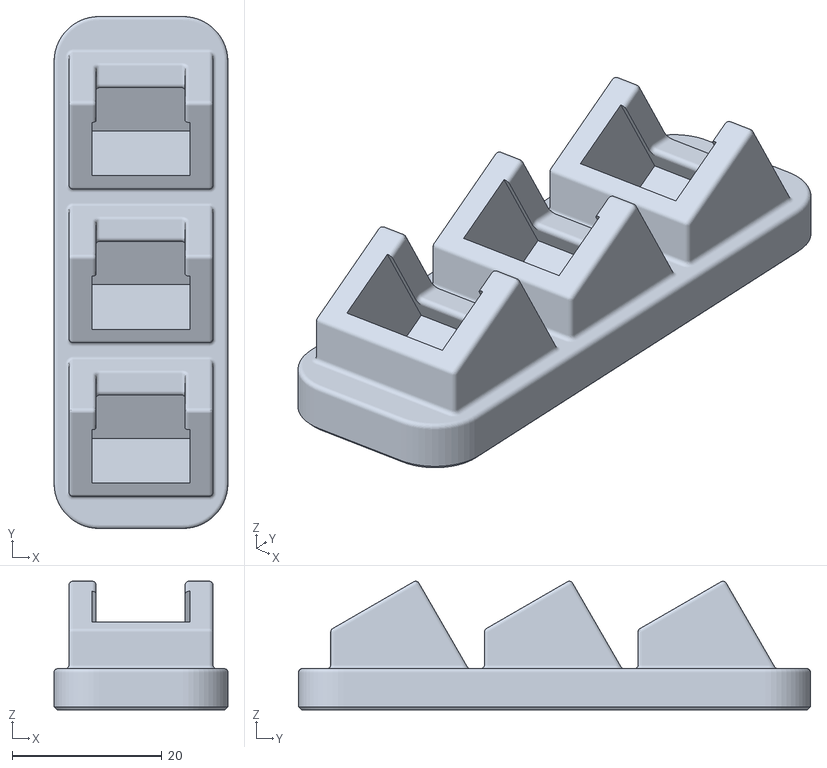
[picture p88: CAD file, 2022-01-01]
WagoMounts/STLs/Wago_3x_221-412_DIN_Mount.stl
23.2 x 68.3 x 17.2
