LoganFraser/VoronMods/WagoMounts/STLs/Wago_3x_221-413_DIN_Mount.stl

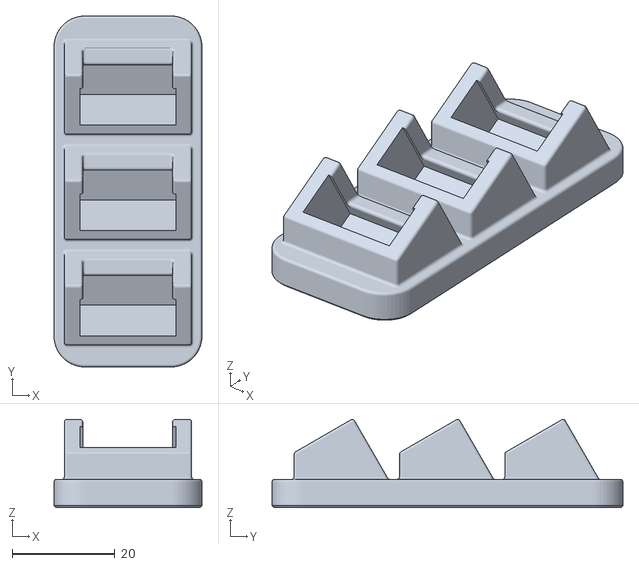
[picture p89: CAD file, 2022-01-01]
WagoMounts/STLs/Wago_3x_221-413_DIN_Mount.stl
28.8 x 68.3 x 17.2
