LoganFraser/VoronMods/WagoMounts/STLs/Wago_3x_221-415_DIN_Mount.stl

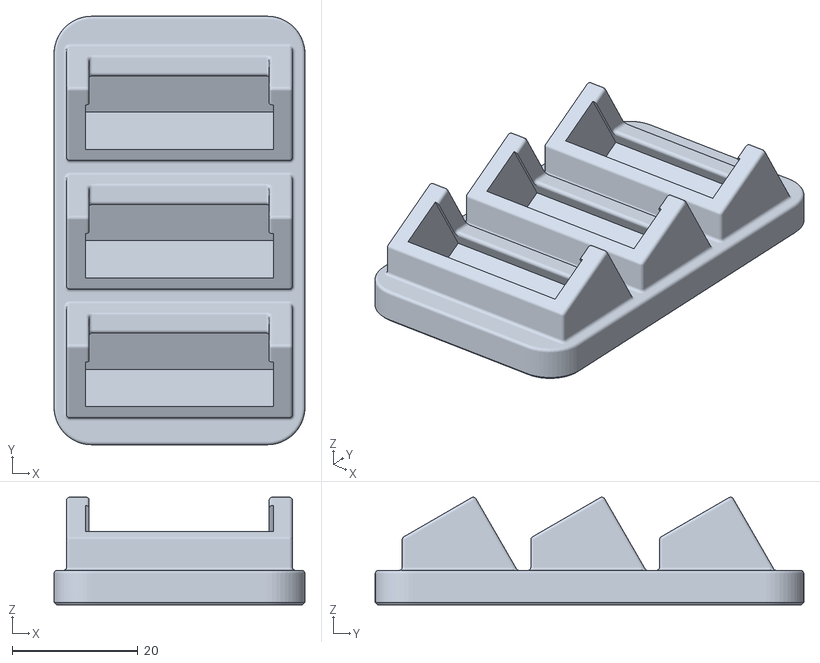
[picture p90: CAD file, 2022-01-01]
WagoMounts/STLs/Wago_3x_221-415_DIN_Mount.stl
40.0 x 68.3 x 17.2
