LoganFraser/VoronMods/(list of files, cad)

Other CAD files:
ComboInlet/STLs/Trident_ComboWideInlet.stl
Displays/BTT PITFT43 LCD Mount v8.step
PiPlate/STLs/2.4r2_Skirt_for_PiPlate.stl
Trident Idler Tensioner/STLs/[a]_tensioner_right.stl
TridentInvertedElectronics/STLs/Inverted_DIN_Mount(Mirror)_x2.stl
ParametricRemovable270Hinges/3mmPanel-1mmfoam-270swing-STLs/HingeDoor.stl
ComboInlet/STLs/Trident_ComboNarrowInlet.stl
Displays/Waveshare 4.3in DSI LCD Case Front.stl
ParametricRemovable270Hinges/3mmPanel-1mmfoam-270swing-STLs/HingeFrame(Mirror).stl
PiPlate/STLs/Pi4Plate.stl
TridentInvertedElectronics/r1 STLs/Din Rail Support(Mirror) x2.stl
TridentInvertedElectronics/STLs/Z_Motor_Mount_Small_Right.stl
ComboInlet/CAD/Trident_2.4_ComboInletSkirt v8.f3d
ComboInlet/CAD/Trident_2.4_ComboInletSkirt_v6.f3d
ComboInlet/CAD/Trident_2.4_ComboInletSkirt_v6.step
DecontaminatorTrident/CAD/DecontaminatorTridentv4.f3d
Displays/BTT PITFT43 LCD Mount v8.f3d
Displays/Fysetc CTP40 LCD Mount.f3d
Displays/Waveshare 4.3in DSI LCD Mount v2.f3d
FFC_24pin_PCBs_and_Mounts/CAD/Breakout_PCB_Microfit_EXP1_Mount_v2.f3d
FFC_24pin_PCBs_and_Mounts/CAD/Gantry_Trident_2.4_FFCv2.f3d
FFC_24pin_PCBs_and_Mounts/CAD/XY_FFC24pin_PCB_ Mountv5.f3d
FFC_24pin_PCBs_and_Mounts/CAD/YZ_FFC24pin_PCB_Mountv8.f3d
HorseshoeSpoolHolder/CAD/HorseshoeSpoolHolder_v10.f3d
HorseshoeSpoolHolder/STLs/PlasticBolt(x3).stl
HorseshoeSpoolHolder/STLs/ShortPlasticBolt(3x).stl
PTFEWrangler/PTFEsupport v7.f3d
ParametricRemovable270Hinges/Parametric 270 Removable Hinge v14.f3d
ParametricRemovable270Hinges/Parametric 270 Removable Hinge v17.f3d
ParametricRemovable270Hinges/Parametric 270 Removable Hinge v19.f3d
ParametricRemovable270Hinges/Parametric 270 Removable Hinge v21.f3d
TridentInvertedElectronics/old_R1_STLs/Din Rail Support(Mirror) x2.stl
TridentInvertedElectronics/old_R1_STLs/M5 Nut Block x8.stl
TridentInvertedElectronics/old_R1_STLs/Z_Motor_Mount_Right.stl
TridentInvertedElectronics/r1 STLs/M5 Nut Block x8.stl
TridentZStepperSpacer/TridentZStepperSpacer.f3d
WagoMounts/CAD/Wago_221-41x_Extrusion_&_Thin_Din_Mount.f3d
WagoMounts/CAD/Wago_3x_221-41x_Angled_Din_Rail_Mount.f3d
