LoganFraser/VoronMods/(threads)

Thread 1 (2022-01-09):

Feature Request: Wago 221-413 Extrusion Mount?

emolitor, 2022-01-09:
Would be nice to also have a 221-413 extrusion mount.

LoganFraser, 2022-02-14:
I'll make one up. I added a 3x 413 din mount already.

Closed 2022-02-14.

Thread 2 (2022-01-30):

Parametric 270 Removable Hinge v19 - Surfaces not prallel

310weber, 2022-01-30:
Logan - thank you so much for this design.  The hinges are awesome.

One quick bit of feedback.  Some of the surfaces of the hinges are not perfectly parallel with each other in the model. For example, the front face and the face of the voron logo are 0.103 deg off from each other.
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

This causes a cosmetic issue when printing the logo - one small corner of the logo starts printing on one layer, while the rest of the logo prints on the next.
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

310weber, 2022-02-01:
I was able to fix the issue by deleting most of the "Position" features from the design history.
[Parametric 270 Removable Hinge v20.zip](https://github.com/LoganFraser/VoronMods/files/7975478/Parametric.270.Removable.Hinge.v20.zip)

LoganFraser, 2022-02-15:
Thanks for noticing this, I went through and deleted the position features and it's clean now.

Closed 2022-02-15.

Thread 4 (2022-06-09):

Not an issue, more a question

wattsie, 2022-06-09:
Hi Logan,
  Not an issue, more a question.

  In the image of your trident and the Horseshoe Spool Holder, I see two support brackets one at the top holding you PTFE tube the other guide on the toolhead.

  Could you please let me know what that parts are, are they your design or do you have a name (or link) so I can search for them.

  Many thanks in advance.

Cheers.

wattsie, 2022-06-27:
Hi Logan,
Never mind, I found this one.
https://github.com/GalvanicGlaze/Voron_Mods
Cheers.

Closed 2022-06-27.

Thread 5 (2023-03-17):

Z offset issues

rmilyard, 2023-03-17:
So I am following your guide on my Trident and not coming out right.  The final steps I get offset 0.535 but z_calibration offset is 5.10000

rmilyard, 2023-03-17:
So for this:

Ensure your position_endstop is correct in printer.cfg
Set your position_endstop to 0 >>> Save & Restart
Home XYZ and then move your nozzle to bed center, and jog until you touch a piece of paper.
Take your current Z value and edit position_endstop to match, but invert the value. Eg Z0.34 = position_endstop: -0.34 >>> Save & Restart

I get z-3.100 so would I change  position_endstop to 3.100 ??
