LoganFraser/VoronMods/(list of files, drawings)

Other design files:
FFC_24pin_PCBs_and_Mounts/FFC24pinPCBsV0.2_EasyEDA/PCB_Breakout_Microfit_EXP1_2022-07-02.json
FFC_24pin_PCBs_and_Mounts/FFC24pinPCBsV0.2_EasyEDA/PCB_Stealthburner-1PC_FFC_JST-XH_2022-07-01.json
FFC_24pin_PCBs_and_Mounts/FFC24pinPCBsV0.2_EasyEDA/PCB_Stealthburner-2PC-Fan_2022-07-01.json
FFC_24pin_PCBs_and_Mounts/FFC24pinPCBsV0.2_EasyEDA/PCB_Stealthburner-2PC_FFC_JST-XH_2022-07-01.json
FFC_24pin_PCBs_and_Mounts/FFC24pinPCBsV0.2_EasyEDA/PCB_XY_FFC_2022-07-01.json
FFC_24pin_PCBs_and_Mounts/FFC24pinPCBsV0.2_EasyEDA/PCB_YZ_FFC_to_Microfit_2022-07-01.json
FFC_24pin_PCBs_and_Mounts/FFC24pinPCBsV0.2_EasyEDA/SCH_Breakout PCB_Microfit_EXP1_2022-07-01.json
FFC_24pin_PCBs_and_Mounts/FFC24pinPCBsV0.2_EasyEDA/SCH_Breakout PCB_Microfit_EXP1_2022-07-02.json
FFC_24pin_PCBs_and_Mounts/FFC24pinPCBsV0.2_EasyEDA/SCH_Stealthburner-1PC_FFC_JST-XH_2022-07-01.json
FFC_24pin_PCBs_and_Mounts/FFC24pinPCBsV0.2_EasyEDA/SCH_Stealthburner-2PC-Fan_2022-07-01.json
FFC_24pin_PCBs_and_Mounts/FFC24pinPCBsV0.2_EasyEDA/SCH_Stealthburner-2PC_FFC_JST-XH_2022-07-01.json
FFC_24pin_PCBs_and_Mounts/FFC24pinPCBsV0.2_EasyEDA/SCH_XY_FFC_2022-07-01.json
FFC_24pin_PCBs_and_Mounts/FFC24pinPCBsV0.2_EasyEDA/SCH_YZ_FFC_to_Microfit_2022-07-01.json
ObsoletePCBs/Breakout_FFC_EXP1_PCB/PCB_Breakout_FFC_EXP1_2022-05-23.json
ObsoletePCBs/Breakout_Molex_EXP1_PCB/PCB_Breakout_Molex_EXP1_2022-05-23.json
ObsoletePCBs/Stealthburner_2PC_FFC_PCB/PCB_Stealthburner-2PC-Fan_2022-05-23.json
ObsoletePCBs/Stealthburner_2PC_FFC_PCB/PCB_Stealthburner-2PC_FFC_JST-XH_2022-05-23.json
ObsoletePCBs/Stealthburner_2PC_Molex_PCB/PCB_Stealthburner-2PC-Fan_2022-05-23.json
ObsoletePCBs/Stealthburner_2PC_Molex_PCB/PCB_Stealthburner-2PC-JST-XH_2022-05-23.json
ObsoletePCBs/YZ_FFC_PCB/PCB_YZ_PCB_FFC_2022-05-23.json
PCBs/Breakout_FFC_EXP1_PCB/PCB_Breakout_FFC_EXP1_2022-05-23.json
PCBs/Breakout_Molex_EXP1_PCB/PCB_Breakout_Molex_EXP1_2022-05-23.json
PCBs/Stealthburner_2PC_FFC_PCB/PCB_Stealthburner-2PC-Fan_2022-05-23.json
PCBs/Stealthburner_2PC_FFC_PCB/PCB_Stealthburner-2PC_FFC_JST-XH_2022-05-23.json
PCBs/Stealthburner_2PC_Molex_PCB/PCB_Stealthburner-2PC-Fan_2022-05-23.json
PCBs/Stealthburner_2PC_Molex_PCB/PCB_Stealthburner-2PC-JST-XH_2022-05-23.json
PCBs/YZ_FFC_PCB/PCB_YZ_PCB_FFC_2022-05-23.json
