LoganFraser/VoronMods/(commit log)

2021-11-03 renamed files
    [BTT PITFT43 LCD Mount.f3d, BTT TFT35 V3.0 LCD Mount.f3d, Fysetc CTP40 LCD Mount.f3d]
2021-11-03 Added step files
    [BTT PITFT43 LCD Mount.step, BTT TFT35 V3.0 LCD Mount.step, Fysetc CTP40 LCD Mount.step]
2021-11-06 Uploaded Pi Plate with Skirt Mods
2021-11-15 Create Parametric 270 Removable Hinge v11.f3d
    Uploaded p270rh mod
    [Parametric 270 Removable Hinge v11.f3d]
2021-12-01 Corrected an error in the rail support brace length.
2021-12-31 First Version
    [Din Rail Wago 221-41x Mounts.f3d, Din Rail Wago 221-41x Mounts.step]
2022-01-01 Added STLs and Image
    [Wago 221-412 DIN Mount.stl, Wago 221-413 DIN Mount.stl, Wago 221-415 DIN Mount.stl]
2022-01-01 Create RS-25 PSU Bracket.stl
    [RS-25 PSU Bracket.stl]
2022-01-02 Organized and renamed.
    [RS-25 PSU Bracket.stl, Wago 3x 221-412 DIN Mount.stl, Wago 3x 221-413 DIN Mount.stl, Wago 3x 221-415 DIN Mount.stl, Wago 3x 221-415 Extrusion Mount.stl, Wago 3x 221-415 Skirt Inlet Mount.stl, Wago 4x 221-412 & 3x 221-415 Extrusion Mount v2.f3d, Wago 4x 221-412 & 3x 221-415 Extrusion Mount.f3d]
2022-01-03 Updated version to fix through-hole dimension.
    [Parametric 270 Removable Hinge v11.f3d, Parametric 270 Removable Hinge v14.f3d]
2022-01-11 Added files for FFC mods
    [FFC_Y_RISER_increased_height.stl, ffc_anchor.stl]
2022-01-13 Create Parametric 270 Removable Hinge v15.f3d
    [Parametric 270 Removable Hinge v15.f3d]
2022-01-16 Create Parametric 270 Removable Hinge v17.f3d
    Restored 3mm side panel value for 270 degree default, and added some bevels that had gotten removed during some editing.
    [Parametric 270 Removable Hinge v17.f3d]
2022-01-19 Removed file with non-270 parameters set, added drill guide
    [Parametric 270 Removable Hinge v15.f3d, Parametric 270 Removable Hinge v18.f3d]
2022-01-21 Fixed glitch on Drill Guide
    Cleaned up projections causing issues with large front door foam sizes on the drill guide.
    [Parametric 270 Removable Hinge v18.f3d, Parametric 270 Removable Hinge v19.f3d]
2022-02-03 generated STLs
    [2.4 300 Skirt for Pi Plate.stl, 2.4 350 Skirt for Pi Plate.stl, Pi3 Plate.stl, Pi4 Plate.stl, Trident Skirt for Pi Plate.stl]
2022-02-06 Updated file names and added option for 2.4 250.
    [2.4 250 Offset Skirt for Pi Plate.stl, 2.4 250-300 Skirt for Pi Plate.stl, 2.4 300 Skirt for Pi Plate.stl]
2022-02-13 Updated Pitft43 and added Waveshare 4.3
    Added heatset inserts and modeled FHCS screws.
    [BTT PITFT43 LCD Mount v7.f3d, BTT PITFT43 LCD Mount v7.step, BTT PITFT43 LCD Mount.f3d, BTT PITFT43 LCD Mount.step, Waveshare 4.3in DSI LCD Mount v1.f3d, Waveshare 4.3in DSI LCD Mount v1.step]
2022-02-13 removed seldom requested display files, added .stl files for both 4.3 displays.
    [BTT PITFT43 LCD Case Front.stl, BTT TFT35 V3.0 LCD Mount.f3d, BTT TFT35 V3.0 LCD Mount.step, Fysetc CTP40 LCD Mount.step, LCD Case Hinge.stl, LCD Case Rear Brace.stl, Waveshare 4.3in DSI LCD Case Front.stl]
2022-02-13 rotated and saved STLs for printing orientation.
    [BTT PITFT43 LCD Case Front.stl, LCD Case Hinge.stl, LCD Case Rear Brace.stl, Waveshare 4.3in DSI LCD Case Front.stl]
2022-02-13 Create Wago 3x 221-415 Din Rail Mount.stl
    [Wago 3x 221-415 Din Rail Mount.stl]
2022-02-14 Updated with slim din rail mounts.
    [Wago 221-xxx Extrusion & Thin Din Mount v7.f3d, Wago 221-xxx Extrusion & Thin Din Mount v7.step, Wago 2x 221-415 Thin Din Rail Mount.stl, Wago 3x 221-413 Thin Din Rail Mount.stl, Wago 4x 221-412 & 3x 221-415 Extrusion Mount.f3d, Wago 4x 221-412 & 3x 221-415 Extrusion Mount.step]
2022-02-14 repair minor chamfer glitch
    [Wago 221-xxx Extrusion & Thin Din Mount v7.f3d, Wago 221-xxx Extrusion & Thin Din Mount v7.step, Wago 221-xxx Extrusion & Thin Din Mount v8.f3d, Wago 221-xxx Extrusion & Thin Din Mount v8.step, Wago 2x 221-415 Thin Din Rail Mount.stl, Wago 3x 221-413 Thin Din Rail Mount.stl]
2022-02-14 Added 3x 221-413 extrusion mount
    [Wago 221-xxx Extrusion & Thin Din Mount v8.f3d, Wago 221-xxx Extrusion & Thin Din Mount v8.step, Wago 221-xxx Extrusion & Thin Din Mount v9.f3d, Wago 221-xxx Extrusion & Thin Din Mount v9.step, Wago 3x 221-413 Extrusion Mount.stl]
2022-02-15 Fixed out of alignment issue identified by 310weber
    [Parametric 270 Removable Hinge v21.f3d]
2022-02-15 Clean up issue with bolt copy.
    [BTT PITFT43 LCD Mount v7.f3d, BTT PITFT43 LCD Mount v7.step, BTT PITFT43 LCD Mount v8.f3d, BTT PITFT43 LCD Mount v8.step, Waveshare 4.3in DSI LCD Mount v1.f3d, Waveshare 4.3in DSI LCD Mount v1.step, Waveshare 4.3in DSI LCD Mount v2.f3d, Waveshare 4.3in DSI LCD Mount v2.step]
2022-02-19 Added options for wagos, updated CAD files.
    [Wago 221-xxx Extrusion & Thin Din Mount v11.f3d, Wago 221-xxx Extrusion & Thin Din Mount v11.step, Wago 221-xxx Extrusion & Thin Din Mount v9.f3d, Wago 221-xxx Extrusion & Thin Din Mount v9.step, Wago 2x 221-415 Extrusion Mount.stl, Wago 5x 221-412 Extrusion Mount.stl]
2022-02-23 Added STLs
    [Bottom_panel_clip x6.stl, Din Rail Support x2.stl, Din Rail Support(Mirror) x2.stl, Fan Cover x2.stl, M5 Nut Block x8.stl, Middle Fan Support x2.stl, Z_Motor_Mount_Left.stl, Z_Motor_Mount_Right.stl]
2022-02-25 updated skirts for 2.4r2
    [2.4r2 Skirt for Pi Plate.stl]
2022-02-27 Added aligned idler tensioner mod for Trident.
    [[a]_tensioner_left.stl, [a]_tensioner_right.stl, front_idler_a_x2.stl, front_idler_b_x2.stl]
2022-03-04 Added stls for common 3mm panel thickness
    [BackPlate 2x.stl, Drill Guide.stl, HingeDoor(Mirror).stl, HingeDoor.stl, HingeFrame(Mirror).stl, HingeFrame.stl]
2022-03-13 Added Trident r2 Inverted Electronics
    [Bottom_panel_clip x6.stl, Din Rail Support x2.stl, Din Rail Support(Mirror) x2.stl, Fan Cover x2.stl, M5 Nut Block x8.stl, Middle Fan Support x2.stl, Sepper_Spacer_Cover13mm.stl, Sepper_Spacer_Cover20mm.stl]
2022-03-13 repositioned for print orientation.
    [r2 Din Rail Support x2.stl, r2 Din Rail Support(Mirror) x2.stl]
2022-04-01 Set print orientation.
    [BackPlate 2x.stl, Drill Guide.stl, HingeDoor(Mirror).stl, HingeDoor.stl, HingeFrame(Mirror).stl, HingeFrame.stl]
2022-04-04 Added skirt pieces for combo inlet
    [TridentComboInletv1.f3d, TridentComboNarrowInlet.stl, TridentComboWideInlet.stl]
2022-04-06 Added 2.4r2 skirt pieces
    [2.4r2 Combo Narrow Inlet.stl, 2.4r2 Combo Wide Inlet.stl, Trident Combo Narrow Inlet.stl, Trident Combo Wide Inlet.stl, TridentComboInletv1.f3d, Voron Trident 2.4r2 Combo Inlet Skirt.f3d]
2022-04-07 Fixed issues with V2.4r2 STLs and set to print orientation.
    [2.4r2 Combo Narrow Inlet.stl, 2.4r2 Combo Wide Inlet.stl, Trident 2.4r2 Combo Inlet Skirt v2.f3d, Trident Combo Narrow Inlet.stl, Trident Combo Wide Inlet.stl, Voron Trident 2.4r2 Combo Inlet Skirt.f3d]
2022-04-15 rename and orient PiPlate STLs for printing, add .step file for 2.4r2
    [2.4 250 Offset Skirt for Pi Plate.stl, 2.4 250-300 Skirt for Pi Plate.stl, 2.4 350 Skirt for Pi Plate.stl, 2.4_250-300_Skirt_for_PiPlate.stl, 2.4_250_Offset_Skirt_for_PiPlate.stl, 2.4_350_Skirt_for_PiPlate.stl, 2.4r2 Skirt for Pi Plate.stl, 2.4r2_Skirt_for_PiPlate.stl]
2022-04-16 Added rear Z mount for front/back mounted din rails.
    [Inverted_DIN_Mount(Mirror)_x2.stl, Inverted_DIN_Mount_x2.stl, M5 Nut Block x8.stl, Z_Motor_Mount_Left.stl, Z_Motor_Mount_Right.stl, Z_Motor_Mount_Small_Left.stl, Z_Motor_Mount_Small_Rear.stl, Z_Motor_Mount_Small_Right.stl]
2022-04-16 minor adjustment
    [Inverted_DIN_Mount(Mirror)_x2.stl, Inverted_DIN_Mount_x2.stl]
2022-04-26 File name updates
    [2.4r2ComboNarrowInlet.stl, 2.4r2ComboWideInlet.stl, Bottom_panel_clip x6.stl, ComboInletSkirt_Trident_2.4_v2.f3d, Din Rail Support x2.stl, Din Rail Support(Mirror) x2.stl, Din_Mount_Bracket.stl, Fan Cover x2.stl]
2022-04-26 Updated File Names - added 2.4 support
    [2.4_ComboNarrowInlet.stl, 2.4_ComboWideInlet.stl, 2.4r2_ComboNarrowInlet.stl, 2.4r2_ComboWideInlet.stl, ComboInletSkirt_Trident_2.4_v2.f3d, Trident_2.4_ComboInlet_v3.f3d, Trident_2.4_ComboInlet_v3.step, Trident_ComboNarrowInlet.stl]
2022-04-26 Changed Directory Name
    [2.4_ComboNarrowInlet.stl, 2.4_ComboWideInlet.stl, 2.4r2_ComboNarrowInlet.stl, 2.4r2_ComboWideInlet.stl, Trident_2.4_ComboInlet_v3.f3d, Trident_2.4_ComboInlet_v3.step, Trident_ComboNarrowInlet.stl, Trident_ComboWideInlet.stl]
2022-04-26 added chamfers
    [2.4_ComboNarrowInlet.stl, 2.4_ComboWideInlet.stl]
2022-04-29 Added Trident Internal Spool
    [608BearingRing(x3).stl, PlasticBolt(x3).stl, Trident-InternalSpool v4.f3d, Trident-InternalSpoolHolder.stl, Trident-InternalSpool_v4.step]
2022-04-30 Adjusted hole size
    [Trident-InternalSpool v5.f3d, Trident-InternalSpool v5.step, Trident-InternalSpoolHolder.stl, Trident_InternalSpoolHolder.stl]
2022-04-30 renames to remove spaces
    [Trident-InternalSpool v4.f3d, Trident-InternalSpool_v4.step, Trident-InternalSpool_v5.f3d, Trident-InternalSpool_v5.step]
2022-04-30 2part bearing rings and cleaned up cad
    [608BearingRing(6x).stl, 608BearingRing(x3).stl, Trident-InternalSpool_v5.f3d, Trident-InternalSpool_v5.step, Trident-InternalSpool_v6.f3d, Trident-InternalSpool_v6.step, Trident_InternalSpoolHolder.stl]
2022-04-30 Added external STL and rotated for print orientation
    [ExternalSpoolHolder.stl, PlasticBolt(x3).stl, Trident_InternalSpoolHolder.stl]
2022-04-30 Added holes to support V0
    [ExternalSpoolHolder.stl]
2022-05-01 New Cad and name
    [608BearingRing(6x).stl, ExternalSpoolHolder.stl, HorseshoeSpoolHolder_v10.f3d, HorseshoeSpoolHolder_v10.step, PlasticBolt(x3).stl, ShortPlasticBolt(3x).stl, Trident-InternalSpool_v6.f3d, Trident-InternalSpool_v6.step]
2022-05-15 Added trident decontaminator
    [2mmSpacer.stl, 4mmSpacer.stl, BrushHolder.stl, DecontaminatorTridentv4.f3d, DecontaminatorTridentv4.step, TridentBracket.stl, TridentBucket.stl]
2022-05-15 Added panel lever STLs
    [PanelLever.stl, PanelLeverFrameMount.stl]
2022-05-24 Added PCBs, cleaned up directories.
    [FFC_Y_RISER_increased_height.stl, PCB_Breakout_FFC_EXP1_2022-05-23.json, PCB_Breakout_Molex_EXP1_2022-05-23.json, PCB_Stealthburner-2PC-Fan_2022-05-23.json, PCB_Stealthburner-2PC-JST-XH_2022-05-23.json, PCB_Stealthburner-2PC_FFC_JST-XH_2022-05-23.json, ffc_anchor.stl]
2022-05-24 Added YZ FFC PCB
    [PCB_YZ_PCB_FFC_2022-05-23.json]
2022-06-10 Widened opening for wideinlets to 60mm
    [2.4_ComboWideInlet.stl, 2.4r2_ComboWideInlet.stl, Trident_2.4_ComboInletSkirt v6.step, Trident_2.4_ComboInletSkirt_v6.f3d, Trident_2.4_ComboInlet_v3.f3d, Trident_2.4_ComboInlet_v3.step, Trident_ComboWideInlet.stl]
2022-06-10 rotated for printing
    [2.4r2_ComboWideInlet.stl, Trident_ComboWideInlet.stl]
2022-06-28 Added missing chamfers
    [2.4r2_ComboNarrowInlet.stl, 2.4r2_ComboWideInlet.stl, Trident_2.4_ComboInletSkirt v8.f3d, Trident_2.4_ComboInletSkirt v8.step, Trident_2.4_ComboInletSkirt_v6.step, Trident_ComboWideInlet.stl]
2022-07-01 Added FFC PCB source files and gerber files.
    [Gantry_Trident_2.4_FFCv2.f3d, PCB_Breakout_Microfit_EXP1_2022-07-01.json, PCB_Stealthburner-1PC_FFC_JST-XH_2022-07-01.json, PCB_Stealthburner-2PC-Fan_2022-07-01.json, PCB_Stealthburner-2PC_FFC_JST-XH_2022-07-01.json, PCB_XY_FFC_2022-07-01.json, PCB_YZ_FFC_to_Microfit_2022-07-01.json, PickAndPlace_PCB_Breakout_Molex_EXP1_2022-07-01.csv]
2022-07-01 remamed old PCBs directory
    [FFC_Y_RISER_increased_height.stl, PCB_Breakout_FFC_EXP1_2022-05-23.json, PCB_Breakout_Molex_EXP1_2022-05-23.json, PCB_Stealthburner-2PC-Fan_2022-05-23.json, PCB_Stealthburner-2PC-JST-XH_2022-05-23.json, PCB_Stealthburner-2PC_FFC_JST-XH_2022-05-23.json, PCB_YZ_PCB_FFC_2022-05-23.json, ffc_anchor.stl]
2022-07-02 Added jumpers for EXP1 breakout
    [PCB_Breakout_Microfit_EXP1_2022-07-01.json, PCB_Breakout_Microfit_EXP1_2022-07-02.json, PickAndPlace_PCB_Breakout_Microfit_EXP1_2022-07-02.csv, PickAndPlace_PCB_Breakout_Molex_EXP1_2022-07-01.csv, SCH_Breakout PCB_Microfit_EXP1_2022-07-02.json]
2022-07-02 minor update for aux jumper rotation.
    [PCB_Breakout_Microfit_EXP1_2022-07-02.json]
2023-12-09 Added files for PTFEWrangler
    [90degreePTFEsupport.stl, 90degreePTFEsupportcompact.stl, PTFEsupport v6.step]
2023-12-09 added STL and F3D files.
    [Arm Mount.stl, PTFE Long Arm.stl, PTFE Short Arm.stl, PTFEsupport v7.f3d]
